poojithas956/MagnumFC/cart/Screenshot 2026-10-18 132400.png

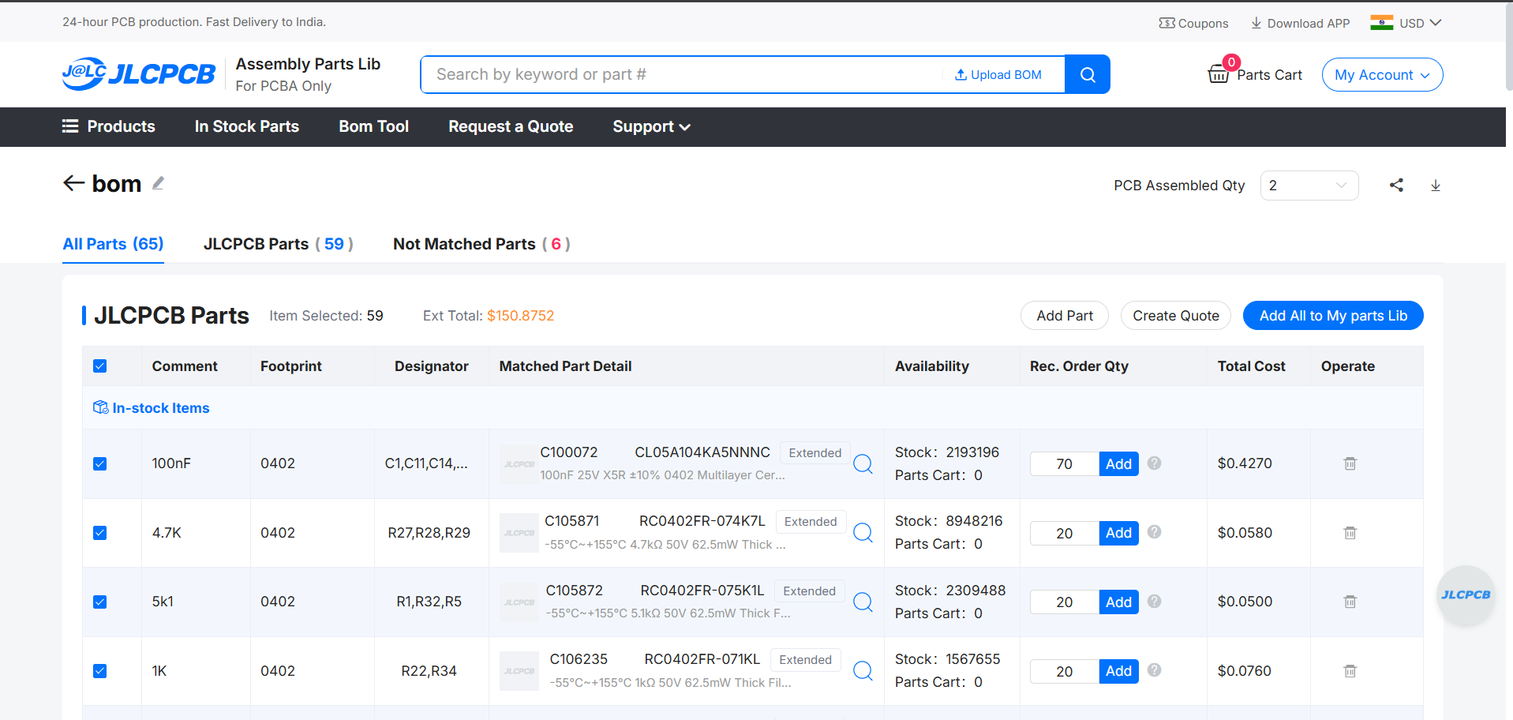
cart/Screenshot 2026-10-18 132400.png
