poojithas956/MagnumFC/cart/Screenshot 2026-10-18 132445.png

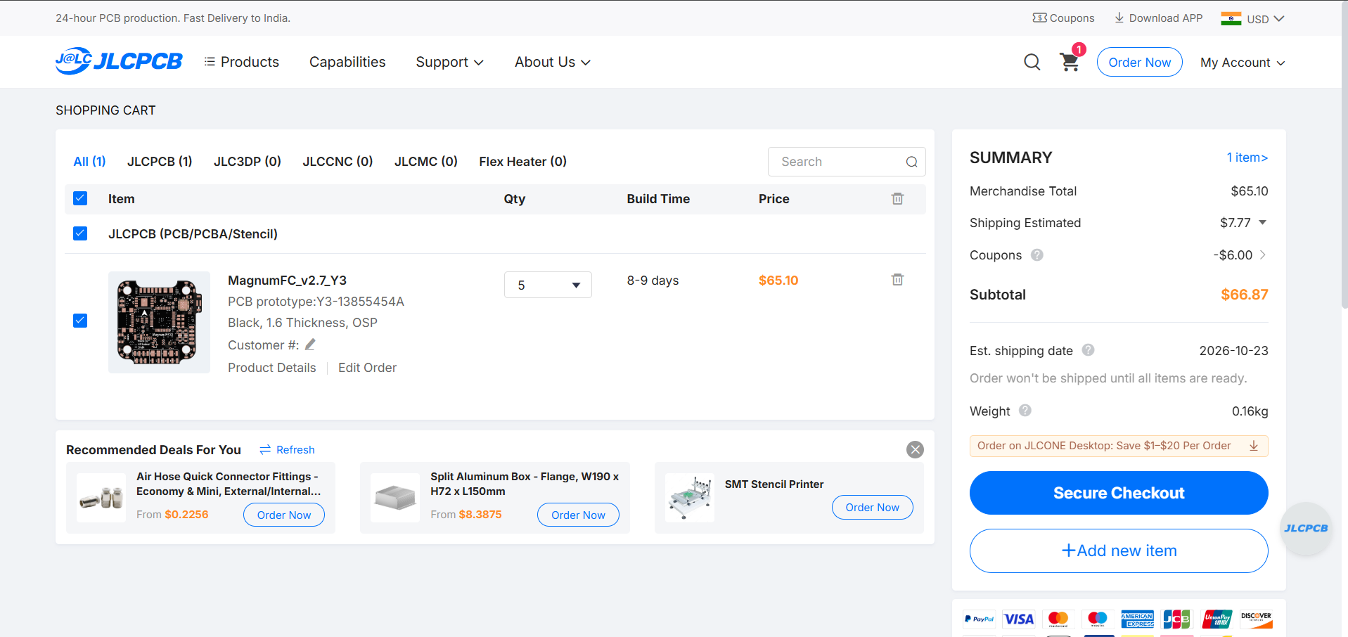
cart/Screenshot 2026-10-18 132445.png
