poojithas956/MagnumFC/PCB/MagnumFC-back.png

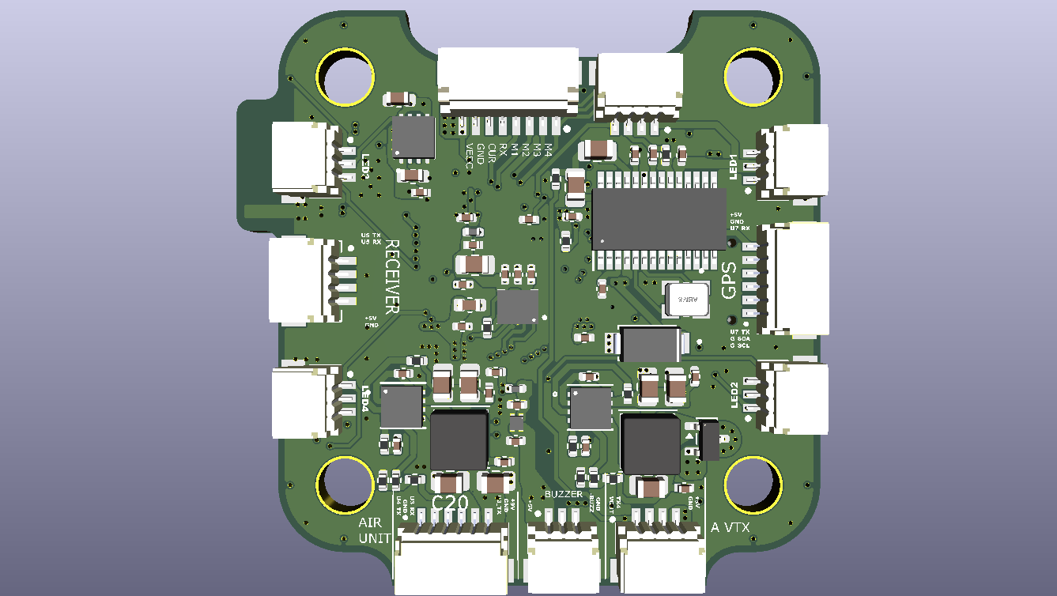
PCB/MagnumFC-back.png
