poojithas956/MagnumFC/PCB/MagnumFC-front.png

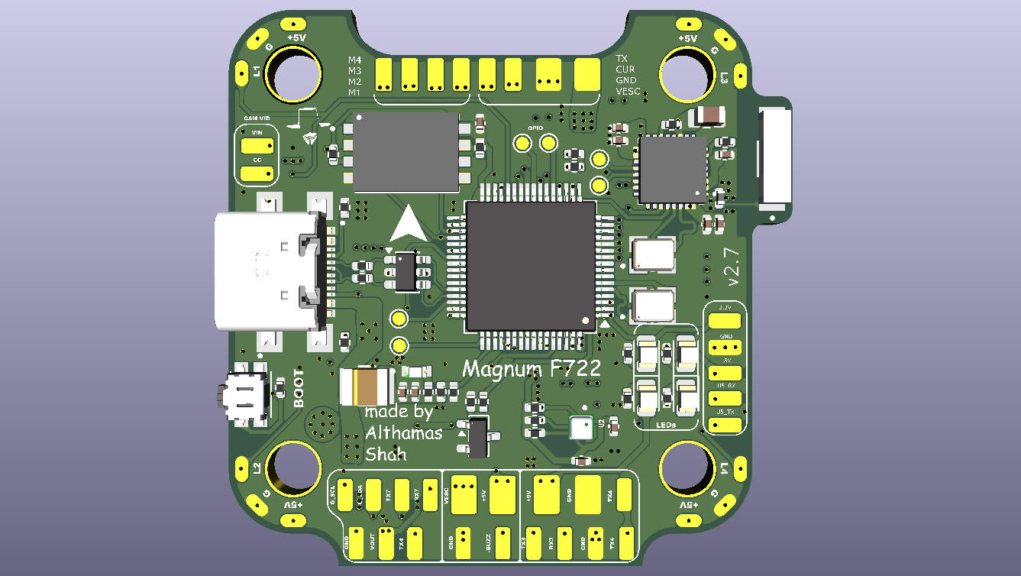
PCB/MagnumFC-front.png
