poojithas956/MagnumFC/Screenshots/3v3 Analog.png

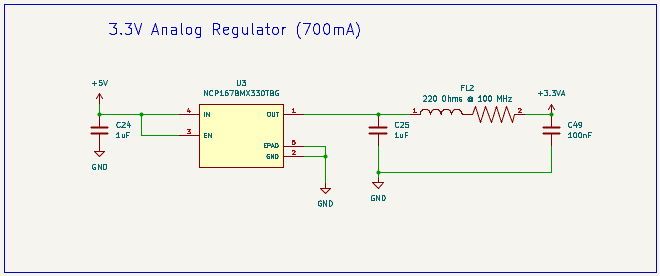
Screenshots/3v3 Analog.png
