poojithas956/MagnumFC/Screenshots/3v3.png

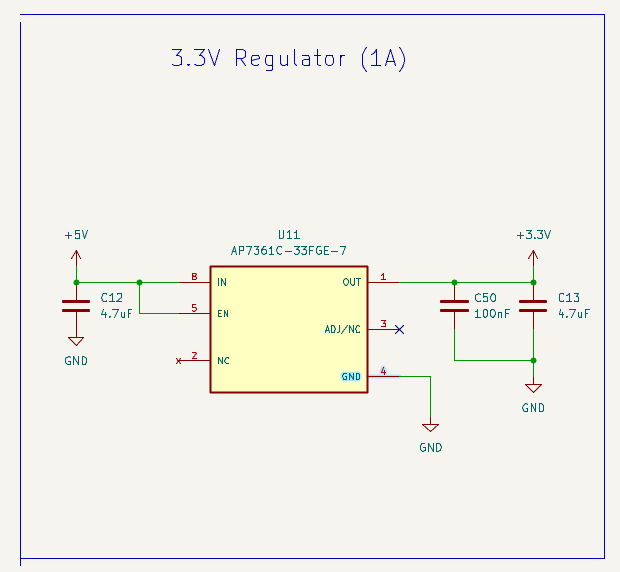
Screenshots/3v3.png
