poojithas956/MagnumFC/Screenshots/back.silkscreen.png

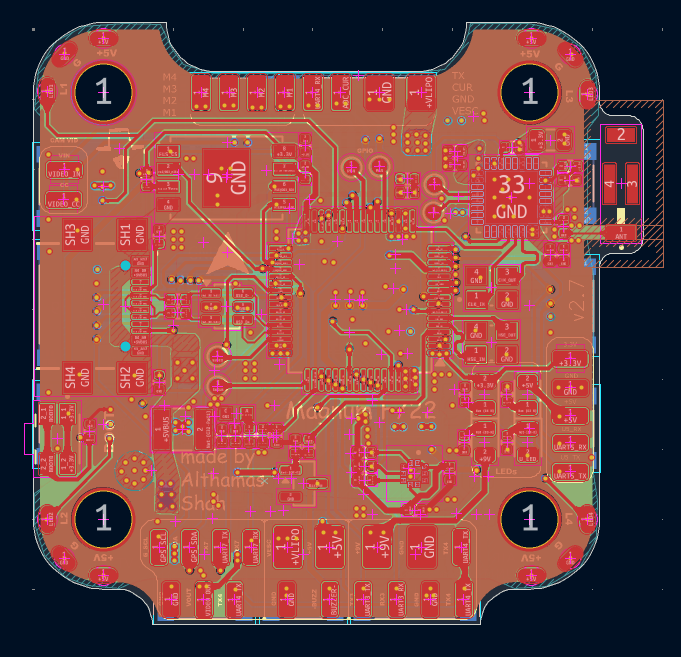
Screenshots/back.silkscreen.png
