poojithas956/MagnumFC/Screenshots/BEC 5v.png

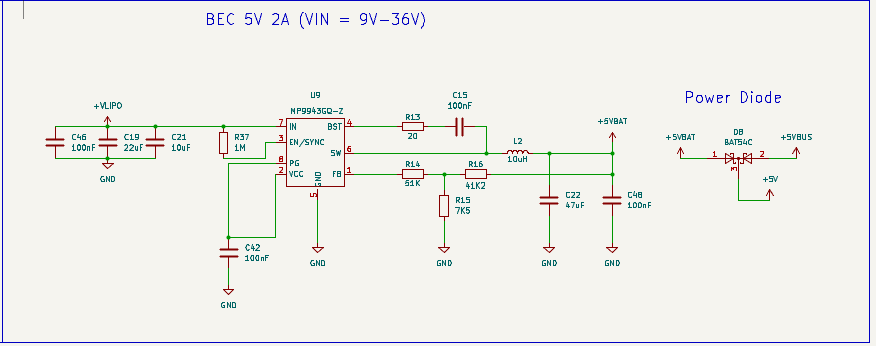
Screenshots/BEC 5v.png
