poojithas956/MagnumFC/Screenshots/BEC 9v.png

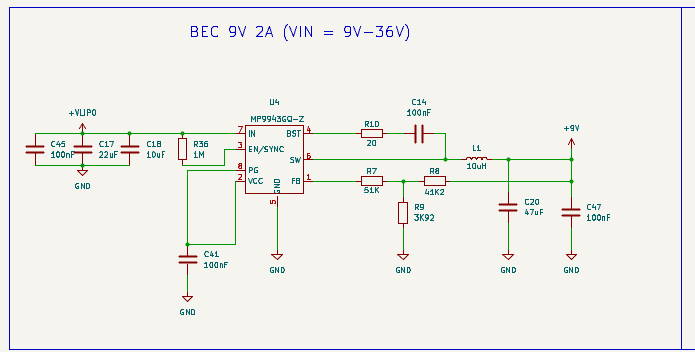
Screenshots/BEC 9v.png
