poojithas956/MagnumFC/Screenshots/Buzzer.png

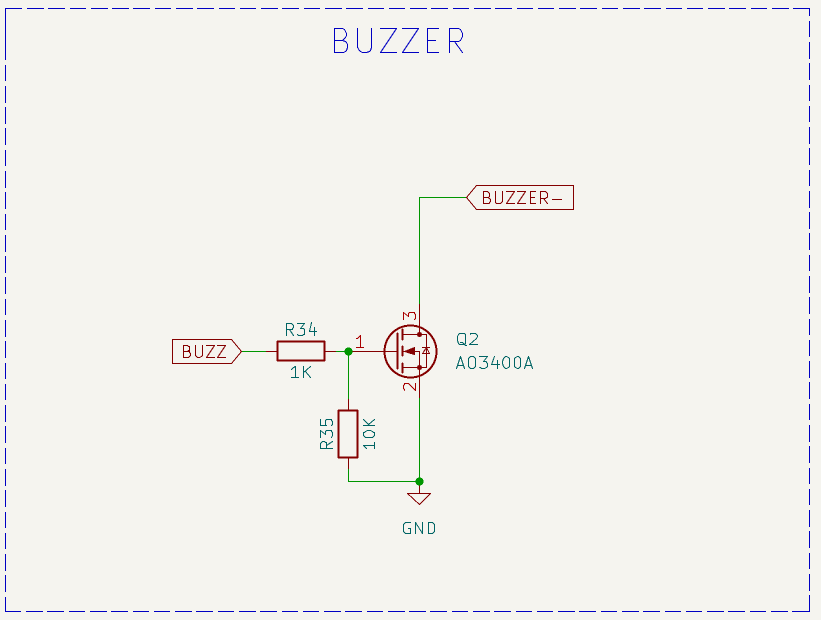
Screenshots/Buzzer.png
