poojithas956/MagnumFC/Screenshots/ESP32-C3.png

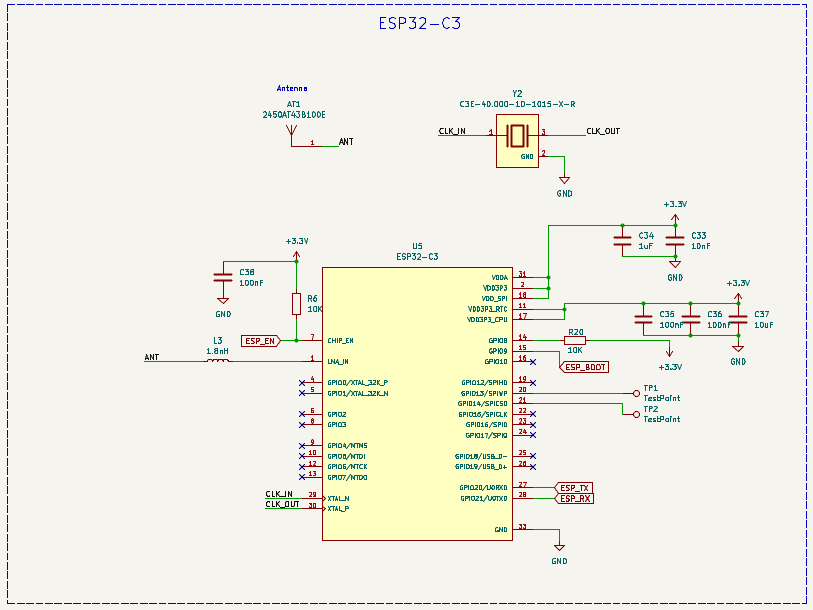
Screenshots/ESP32-C3.png
