poojithas956/MagnumFC/Screenshots/External LEDs.png

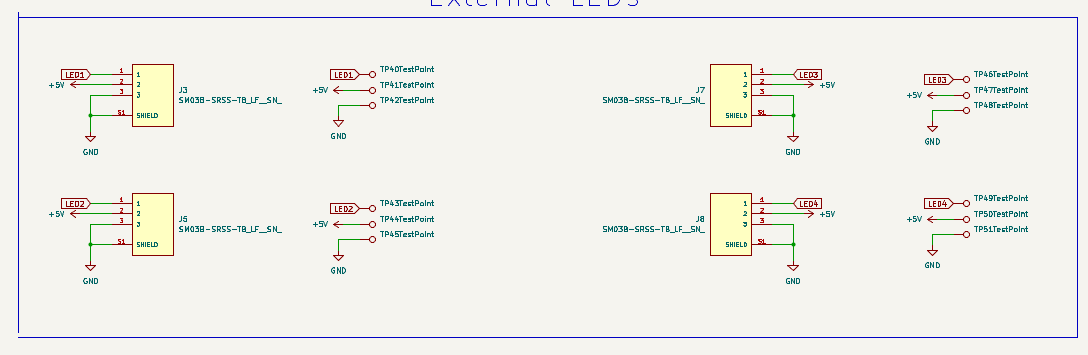
Screenshots/External LEDs.png
