poojithas956/MagnumFC/Screenshots/Flash.png

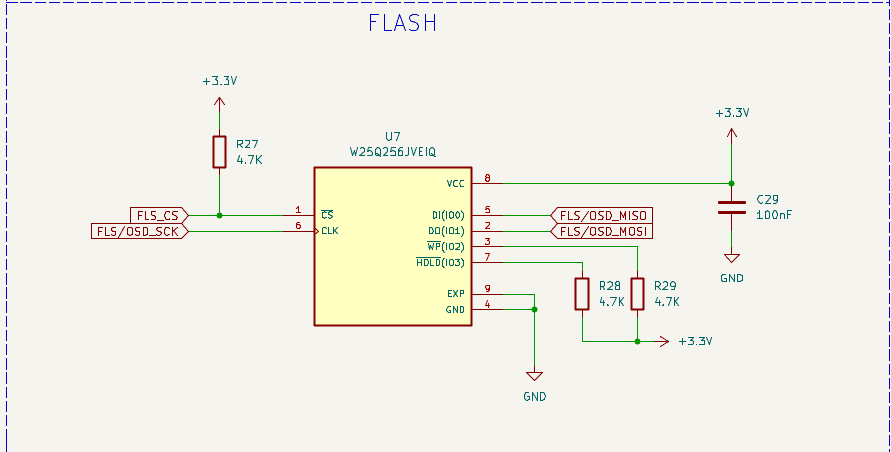
Screenshots/Flash.png
