poojithas956/MagnumFC/Screenshots/front.silkscreen.png

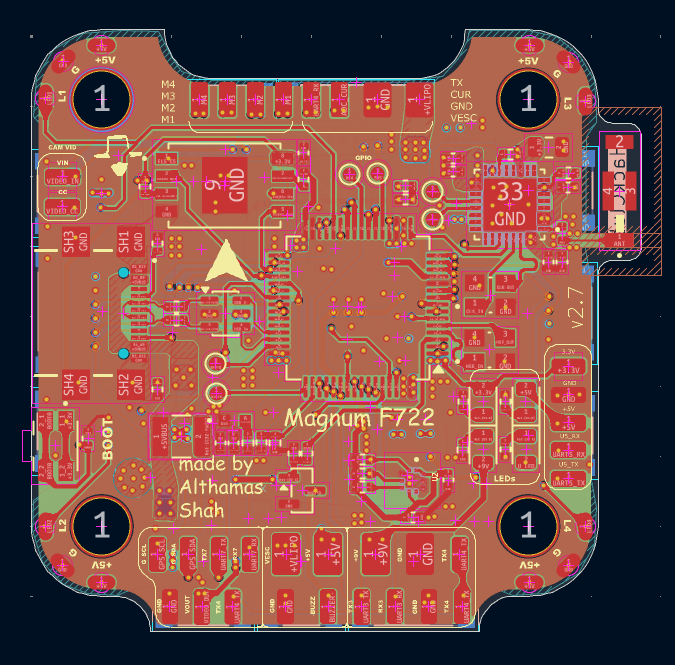
Screenshots/front.silkscreen.png
