poojithas956/MagnumFC/Screenshots/JST conn.png

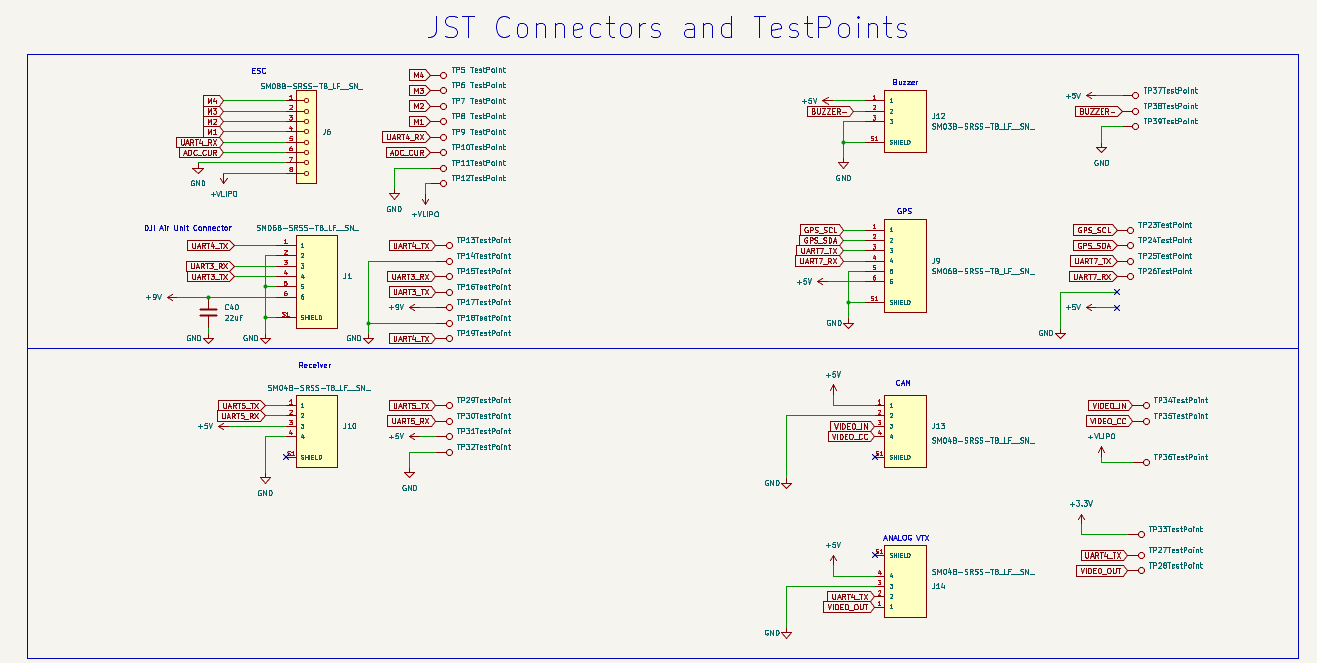
Screenshots/JST conn.png
