poojithas956/MagnumFC/Screenshots/OSD.png

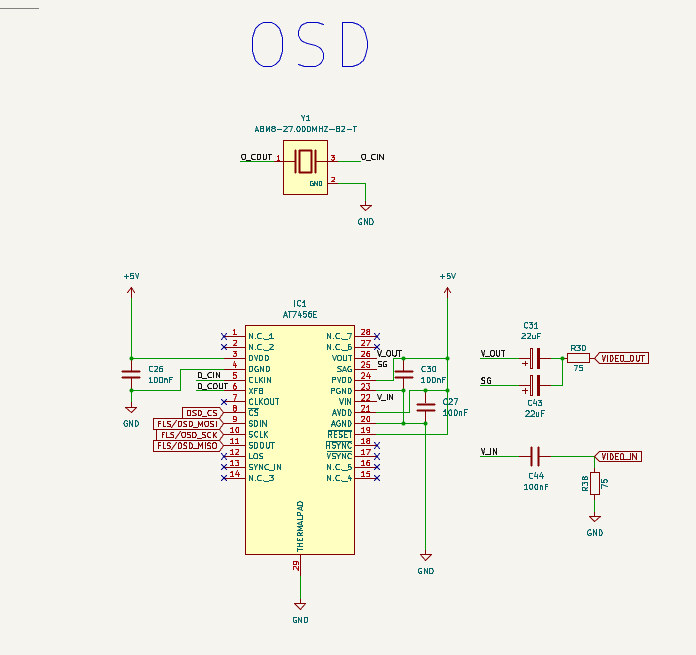
Screenshots/OSD.png
