poojithas956/MagnumFC/Screenshots/PCB.png

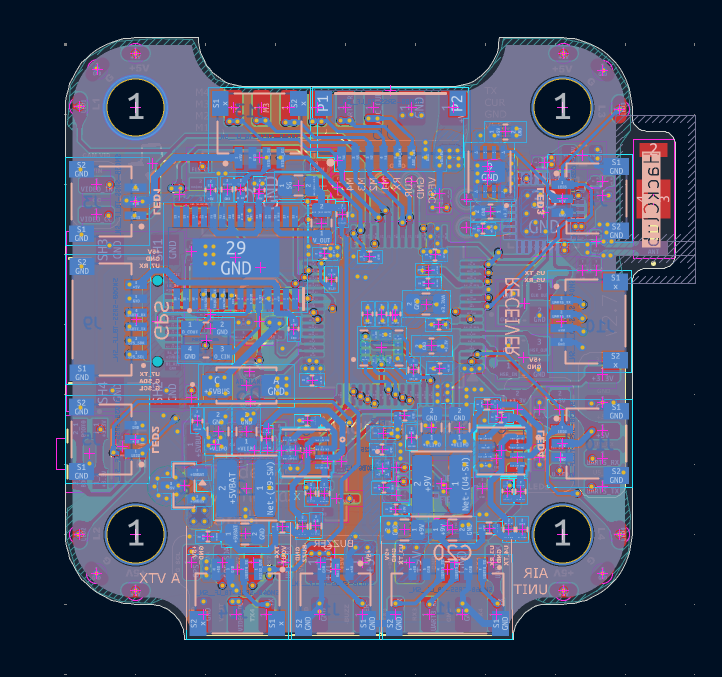
Screenshots/PCB.png
