poojithas956/MagnumFC/Screenshots/Sch2.png

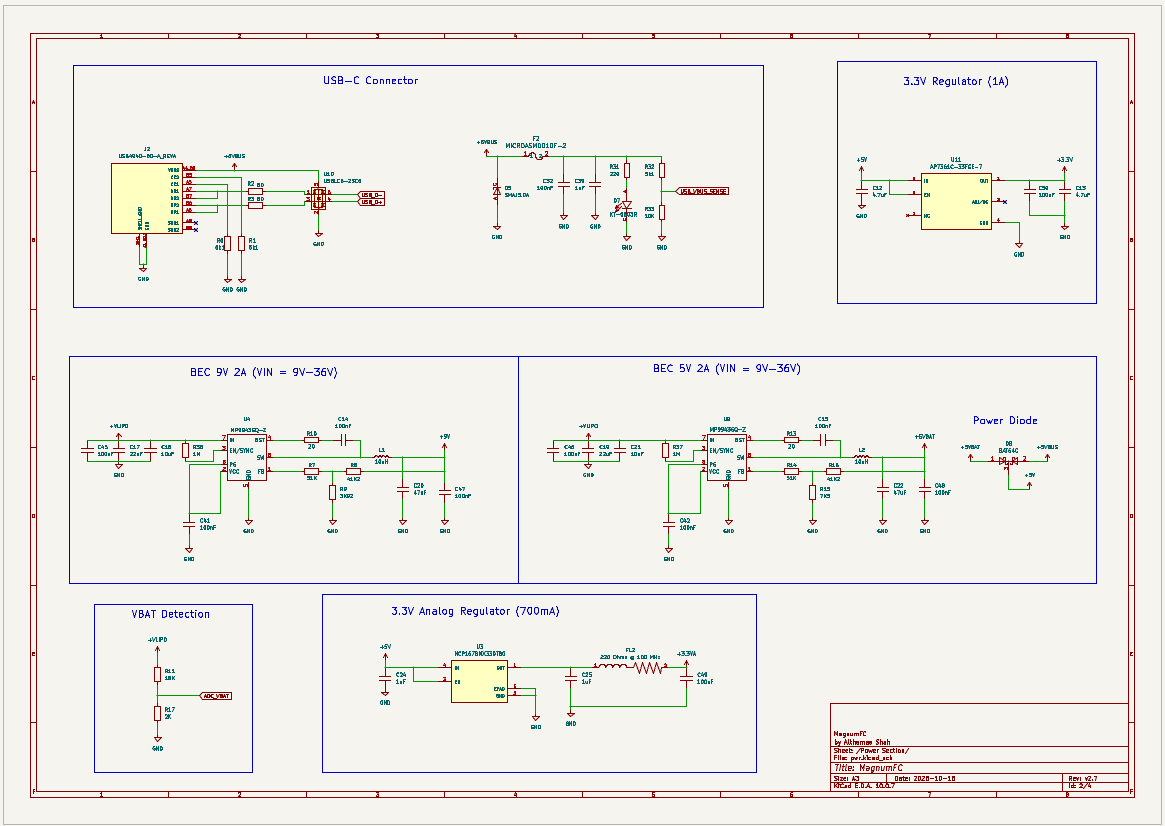
Screenshots/Sch2.png
