poojithas956/MagnumFC/Screenshots/Sch3.png

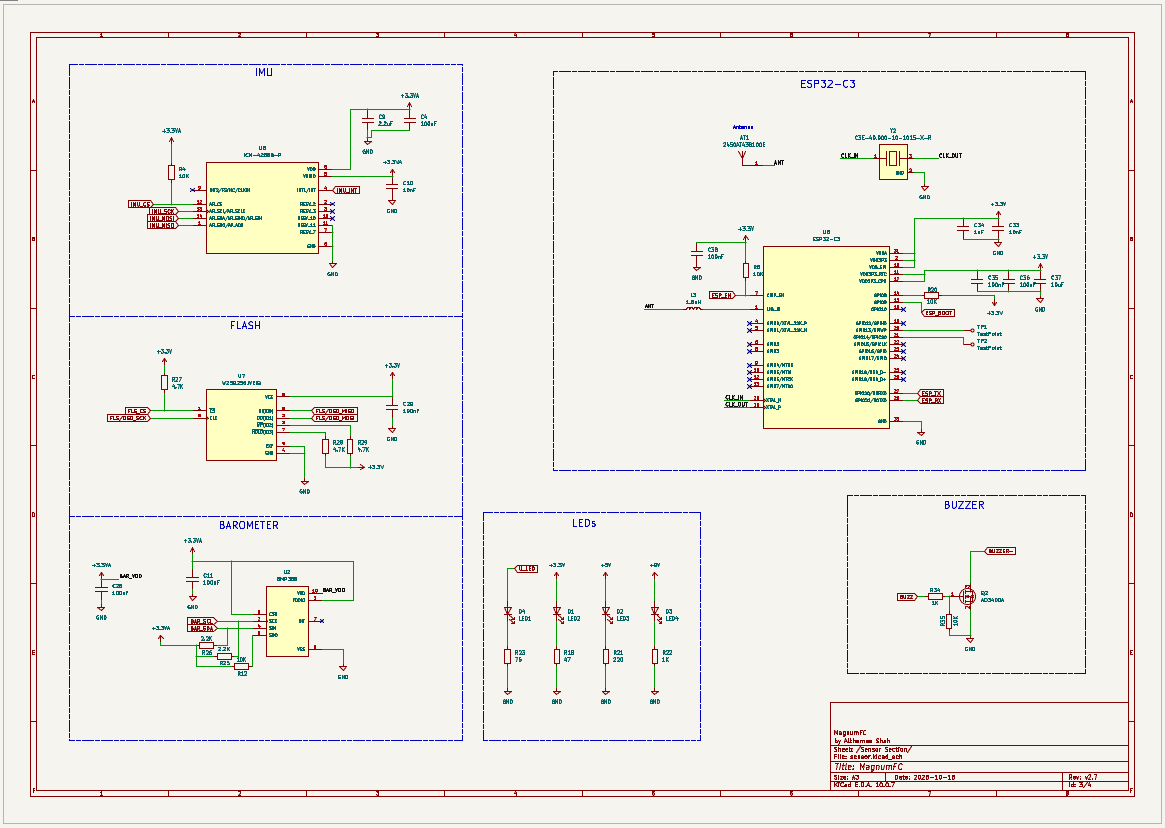
Screenshots/Sch3.png
