poojithas956/MagnumFC/Screenshots/Sch4.png

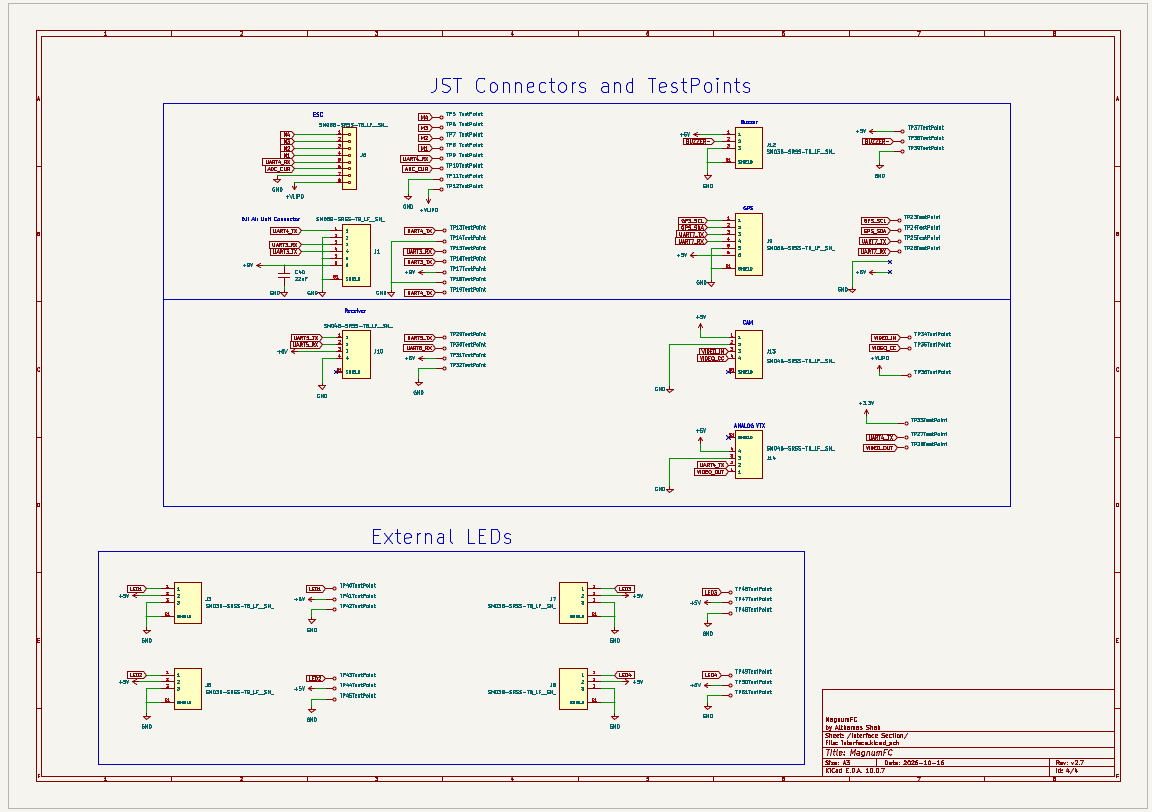
Screenshots/Sch4.png
