poojithas956/MagnumFC/Screenshots/Status LEDs.png

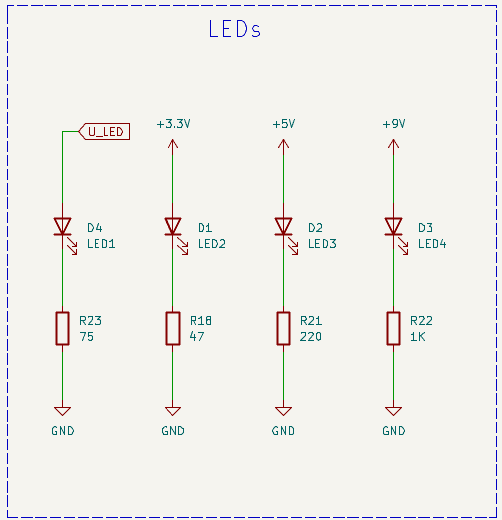
Screenshots/Status LEDs.png
