poojithas956/MagnumFC/Screenshots/VBAT.png

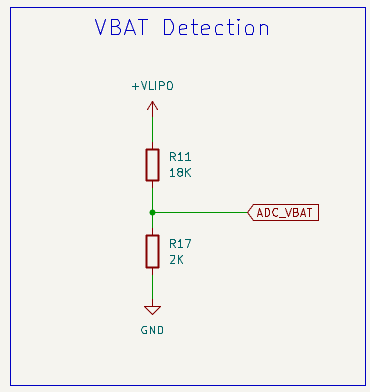
Screenshots/VBAT.png
