poojithas956/MagnumFC/production/bom.csv

Designator | Footprint | Quantity | Value | LCSC Part #
_3, _2, |  | 3
AT1 | ANTENNA_2450AT43B100E | 1 | 2450AT43B100E | C2917721
C1, C11, C14, C15, C16, C2, C23, C26, C27, C28, C29, C3, C30, C32, C35, C36, C38, C4, C41, C42, C44, C45, C46, C47, C48, C49, C50, C6 | 0402 | 28 | 100nF | C100072
C10, C33 | 0402 | 2 | 10nF | C15195
C12, C13, C5 | 0603 | 3 | 4.7uF | C19666
C17, C19, C31, C40, C43 | 0805 | 5 | 22uF | C22367832
C18, C21, C37 | 0805 | 3 | 10uF | C2932476
C20, C22 | 0805 | 2 | 47uF | C5596752
C24, C25, C34, C39 | 0402 | 4 | 1uF | C29266
C7 | 0805 | 1 | 1uF | C24123
C8, C9 | 0402 | 2 | 2.2uF | C107369
D1 | 0805 | 1 | LED2 | C2293
D2 | 0805 | 1 | LED3 | C2296
D3 | 0805 | 1 | LED4 | C2297
D4 | 0805 | 1 | LED1 | C2295
D5 | DIOM4325X250N | 1 | SMAJ5.0A | C83329
D7 | LED_KT-0603R | 1 | KT-0603R | C2286
D8 | SOT-23 | 1 | BAT54C | C14308
F2 | FUSE_MICROASMD010F_LTF | 1 | MICROASMD010F-2 | C2649903
FL1 | 0402 | 1 | 120 Ohms @ 100 MHz | C107331
FL2 | 0402 | 1 | 220 Ohms @ 100 MHz | C85818
IC1 | SOP65P640X120-29N | 1 | AT7456E | C82351
J1, J9 | JST_SM06B-SRSS-TB_LF__SN_ | 2 | SM06B-SRSS-TB_LF__SN_ | C2845365
J10, J13, J14 | JST_SM04B-SRSS-TB_LF__SN_ | 3 | SM04B-SRSS-TB_LF__SN_ | C2845363
J12, J3, J5, J7, J8 | JST_SM03B-SRSS-TB_LF__SN_ | 5 | SM03B-SRSS-TB_LF__SN_ | C2845362
J2 | GCT_USB4940-00-A_REVA | 1 | USB4940-00-A_REVA | C54829818
J6 | JST_SM08B-SRSS-TB_LF__SN_ | 1 | SM08B-SRSS-TB_LF__SN_ | C160407
L1, L2 | L_Changjiang_FTC404020S | 2 | 10uH | C53198553
L3 | 0402 | 1 | 1.8nH | C77107
Q2 | SOT-23 | 1 | AO3400A | C20917
R1, R32, R5 | 0402 | 3 | 5k1 | C105872
R10, R13 | 0402 | 2 | 20 | C138031
R11 | 0402 | 1 | 18K | C25762
R12, R20, R24, R33, R35, R4, R6 | 0402 | 7 | 10K | C60489
R14, R7 | 0402 | 2 | 51K | C107229
R15 | 0402 | 1 | 7K5 | C25918
R16, R8 | 0402 | 2 | 41K2 | C844310
R17 | 0402 | 1 | 2K | C60488
R18 | 0402 | 1 | 47 | C137973
R2, R3 | 0402 | 2 | 80 | C185392
R21, R31 | 0402 | 2 | 220 | C112291
R22, R34 | 0402 | 2 | 1K | C106235
R23, R30, R38 | 0402 | 3 | 75 | C137841
R25, R26 | 0402 | 2 | 2.2K | C163447
R27, R28, R29 | 0402 | 3 | 4.7K | C105871
R36, R37 | 0402 | 2 | 1M | C93949
R9 | 0402 | 1 | 3K92 | C131467
S2 | SW_EVQ-P7A01P | 1 | EVQ-P7A01P | C79167
TP1, TP10, TP2, TP20, TP21, TP3, TP4, TP40, TP41, TP42, TP43, TP44, TP45, TP46, TP47, TP48, TP49, TP5, TP50, TP51, TP6, TP7, TP8, TP9 | TestPoint_Pad_D1.0mm | 24 | TestPoint | -
TP11, TP12 | TestPoint_Pad_D2.0mm | 2 | TestPoint | -
TP13, TP14, TP15, TP16, TP18, TP19, TP23, TP24, TP25, TP26, TP27, TP28, TP29, TP30, TP32, TP33, TP34, TP35, TP36_2, TP38, TP39 | TestPoint_Pad_1.0x1.0mm | 21 | TestPoint | -
TP17, TP31, TP37 | TestPoint_Pad_2.0x2.0mm | 3 | TestPoint | -
TP36 | TestPoint_Pad_1.0x1.0mm | 1 | TestPoint
U1 | LQFP-64_10x10mm_P0.5mm | 1 | STM32F722RETx | C118207
U10 | SOT-23-6 | 1 | USBLC6-2SC6 | C7519
U11 | SON65P300X300X63-9N | 1 | AP7361C-33FGE-7 | C151007
U2 | XDCR_BMP388 | 1 | BMP388 | C779278
U3 | VREG_NCP167BMX330TBG | 1 | NCP167BMX330TBG | C892227
U4, U9 | QFN-8_MP9943_MNP | 2 | MP9943GQ-Z | Mouser No: 946-MP9943GQ-Z
U5 | QFN50P500X500X90-33N | 1 | ESP32-C3 | C2838500
U6 | PQFN50P300X250X97-14N | 1 | ICM-42688-P | C1850418, Mouser No: 410-ICM-42688-P
U7 | IC_W25N04KVZEIR | 1 | W25Q256JVEIQ | C97522
Y1 | XTAL_ABM8-27.000MHZ-B2-T | 1 | ABM8-27.000MHZ-B2-T | C1985251
Y2 | XTAL_C3E-40.000-10-1015-X-R | 1 | C3E-40.000-10-1015-X-R | C5444549
Y3 | XTAL_C3E-8.000-18-3030-X-R | 1 | C3E-8.000-18-3030-X-R | C2682775
