poojithas956/MagnumFC/Screenshots/components-back.png

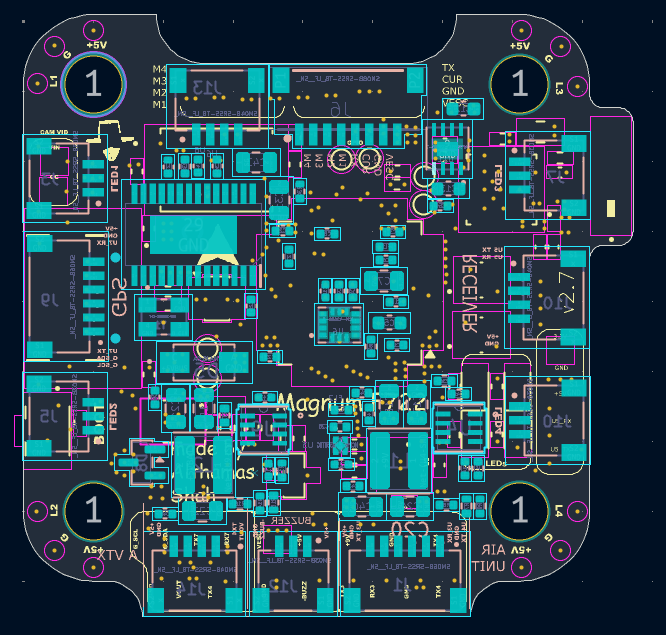
Screenshots/components-back.png
