poojithas956/MagnumFC/Screenshots/components-front.png

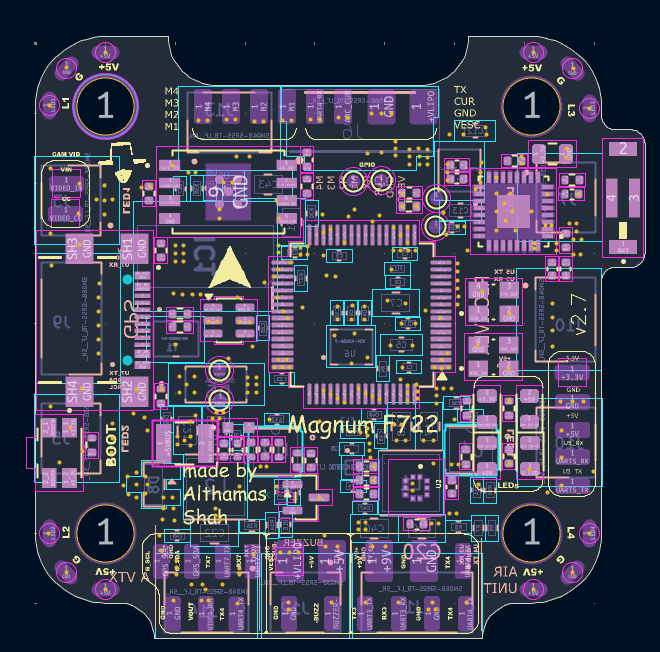
Screenshots/components-front.png
