poojithas956/MagnumFC/PCB/MagnumFC.kicad_pcb

## KiCad design PCB/MagnumFC.kicad_pcb (2026-10-20)

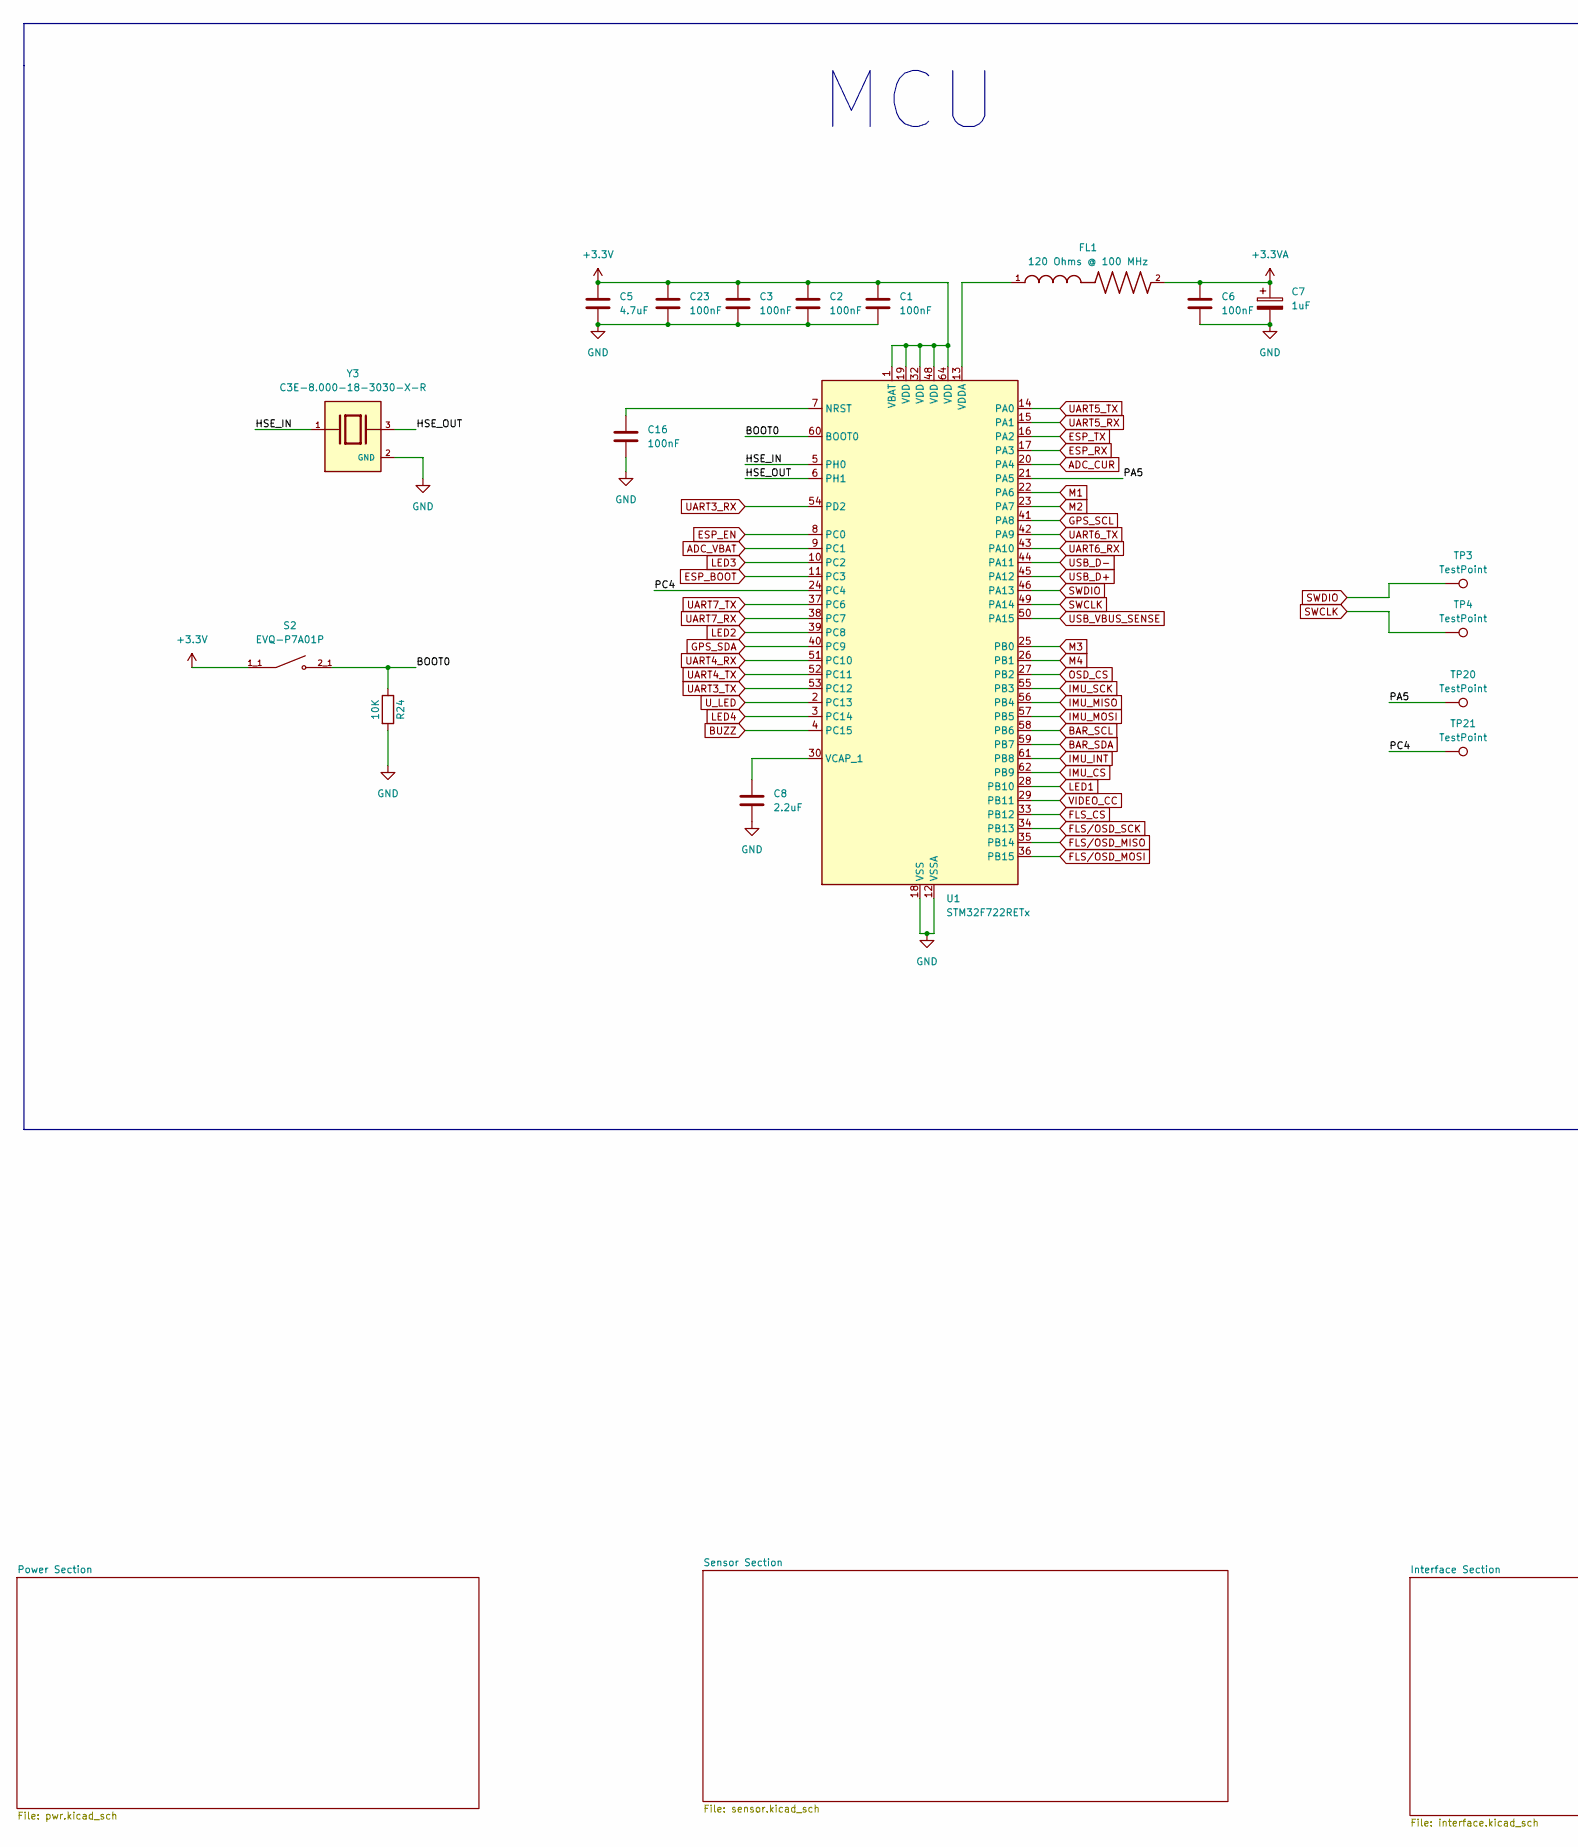
[picture p34: schematic MagnumFC.kicad_sch, part in row 1, column 1]

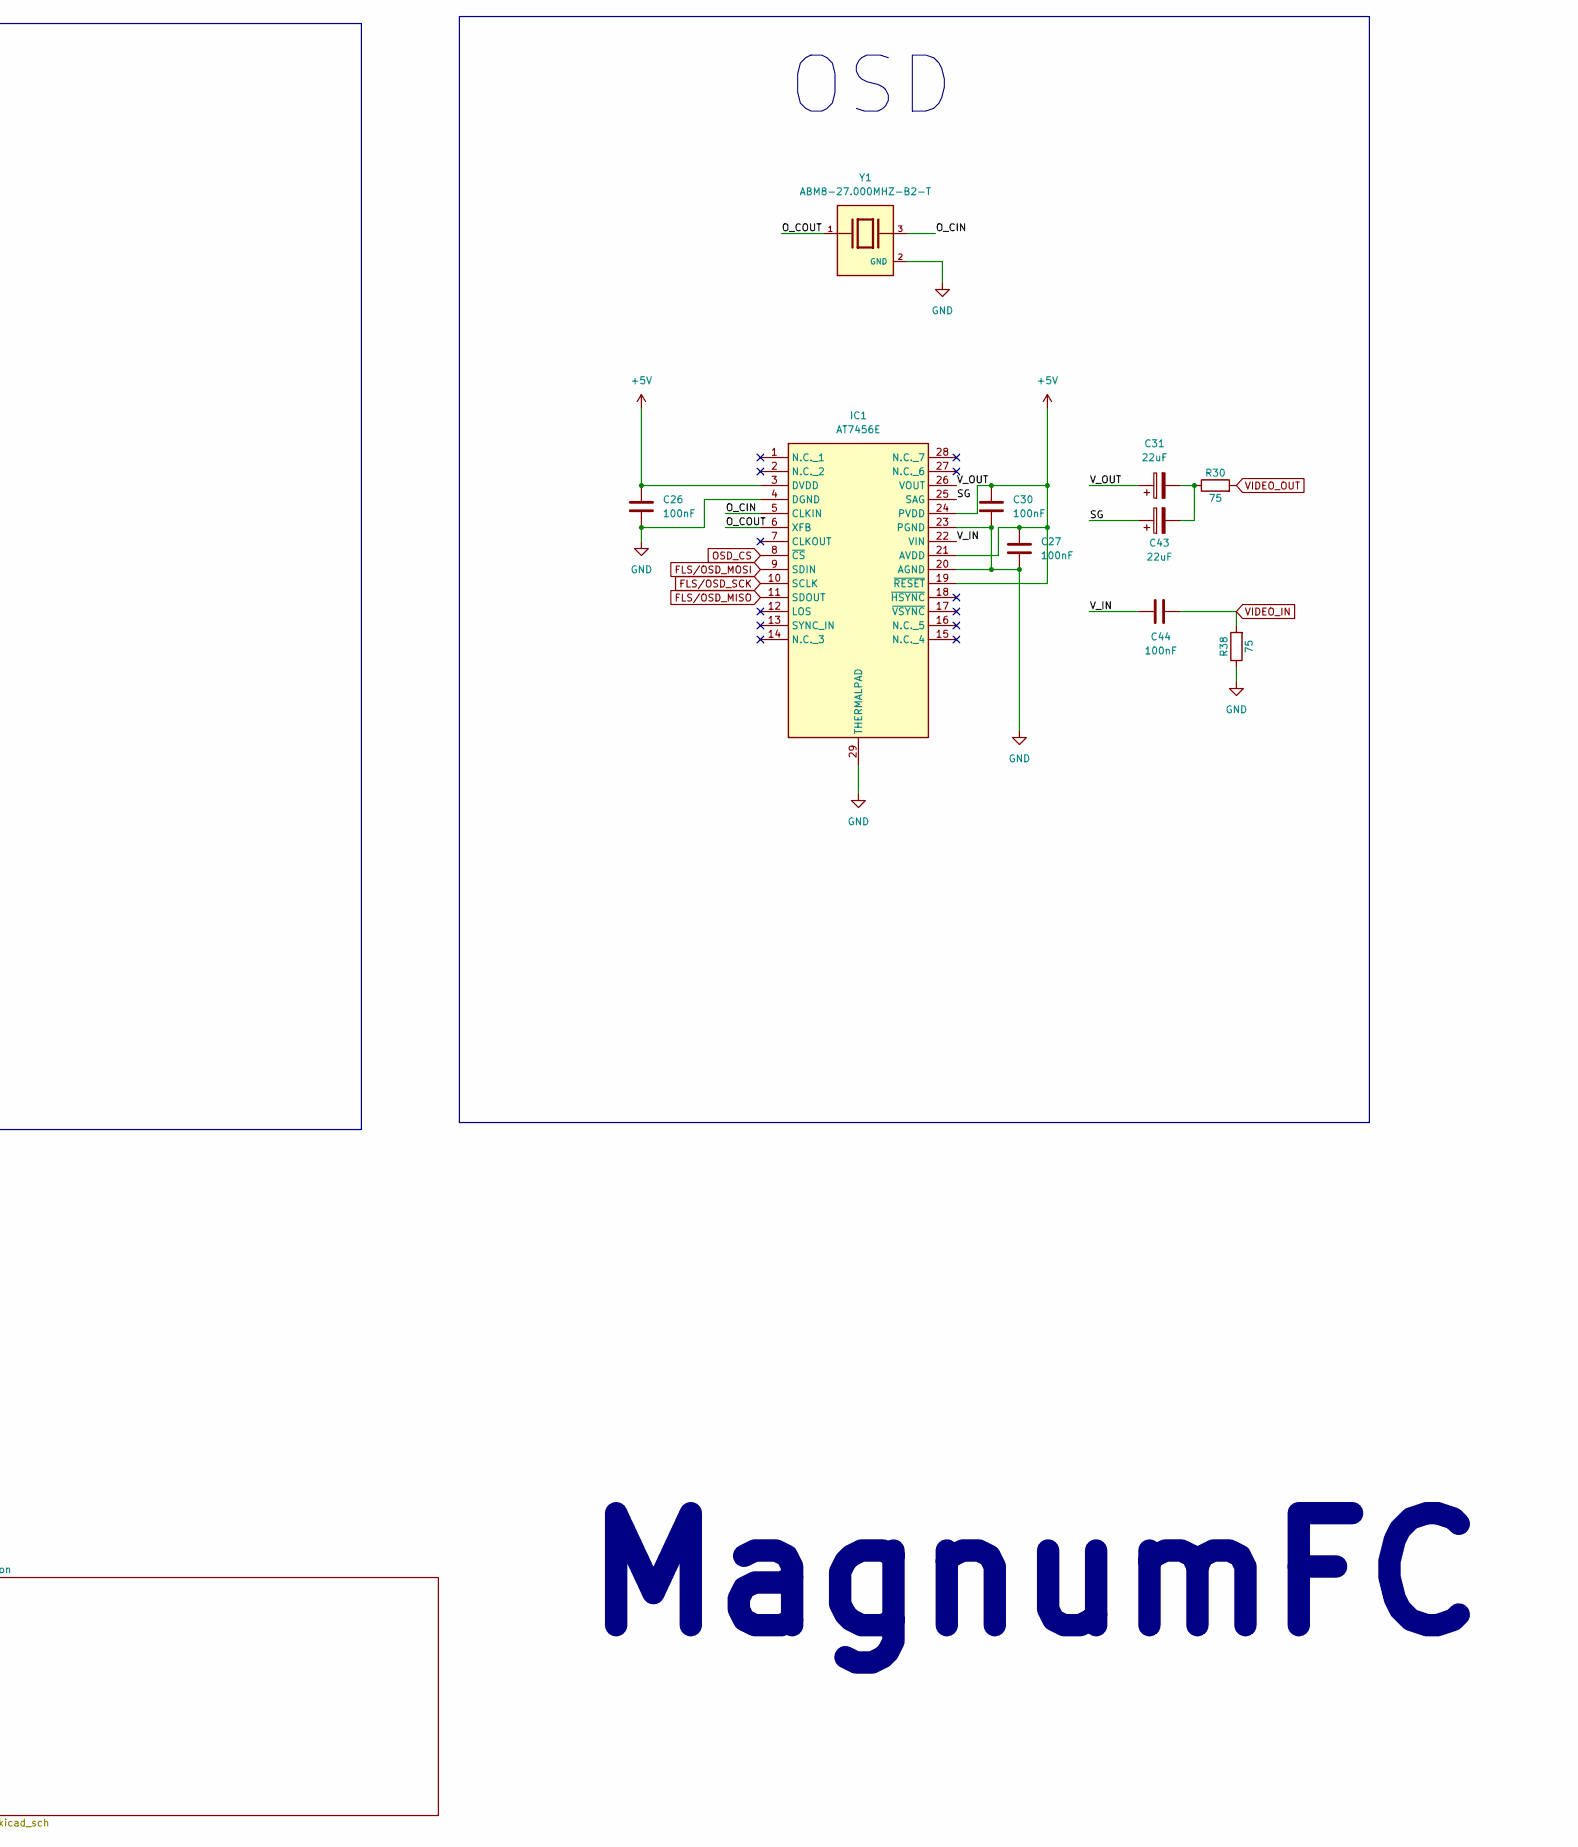
[picture p35: schematic MagnumFC.kicad_sch, part in row 1, column 2]

Parts:
C1, C2, C3, C6, C16, C23, C26, C27, C30, C44: 100nF; C_0402_1005Metric; MANUFACTURER PART NUMBER CL05A104KA5NNNC; LCSC C100072
C5: 4.7uF; C_0603_1608Metric; MANUFACTURER PART NUMBER CL10A475KO8NNNC; LCSC C19666
C7: 1uF; C_0805_2012Metric; MANUFACTURER PART NUMBER CL21B105KOFNNNE; LCSC C24123
C8: 2.2uF; C_0402_1005Metric; MANUFACTURER PART NUMBER CL05A225KP5NSNC; LCSC C107369
C31, C43: 22uF; C_0805_2012Metric; MANUFACTURER PART NUMBER HGC0805R5226M350NSLJ; LCSC C22367832
FL1: 120 Ohms @ 100 MHz; L_0402_1005Metric; MANUFACTURER PART NUMBER MPZ1005S121CT000; LCSC C107331
IC1: AT7456E; SOP65P640X120-29N; Manufacturer_Part_Number AT7456E; LCSC C82351
R24: 10K; R_0402_1005Metric; MANUFACTURER PART NUMBER RC0402JR-0710KL; LCSC C60489
R30, R38: 75; R_0402_1005Metric; MANUFACTURER PART NUMBER RC0402JR-0775RL; LCSC C137841
S2: EVQ-P7A01P; SW_EVQ-P7A01P; PARTREV 2022.4; LCSC C79167
TP3, TP4, TP20, TP21: TestPoint; TestPoint_Pad_D1.0mm
U1: STM32F722RETx; LQFP-64_10x10mm_P0.5mm; MANUFACTURER PART NUMBER STM32F722RET6; LCSC C118207
Y1: ABM8-27.000MHZ-B2-T; XTAL_ABM8-27.000MHZ-B2-T; PARTREV 44041; LCSC C1985251
Y3: C3E-8.000-18-3030-X-R; XTAL_C3E-8.000-18-3030-X-R; PARTREV August 01, 2022; LCSC C2682775

Connections:
+3.3V: C1.1, C2.1, C3.1, C5.1, C23.1, S2.1_1, S2.1_2, U1.1 (VBAT), U1.19 (VDD), U1.32 (VDD), U1.48 (VDD), U1.64 (VDD); also elsewhere on the board
+3.3VA: C6.1, C7.1, FL1.2; also elsewhere on the board
+5V: C26.1, C27.1, C30.1, IC1.3 (DVDD), IC1.19 (~RESET), IC1.21 (AVDD), IC1.24 (PVDD); also elsewhere on the board
/BOOT0: R24.1, S2.2_1, S2.2_2, U1.60 (BOOT0)
/HSE_IN: U1.5 (PH0), Y3.1
/HSE_OUT: U1.6 (PH1), Y3.3
/O_CIN: IC1.5 (CLKIN), Y1.3
/O_COUT: IC1.6 (XFB), Y1.1
/PA5: TP20.1 (1_1), U1.21 (PA5)
/PC4: TP21.1 (1_1), U1.24 (PC4)
/SG: C43.1, IC1.25 (SAG)
/V_IN: C44.1, IC1.22 (VIN)
/V_OUT: C31.1, IC1.26 (VOUT)
ADC_CUR: U1.20 (PA4); also elsewhere on the board
ADC_VBAT: U1.9 (PC1); also elsewhere on the board
BAR_SCL: U1.58 (PB6); also elsewhere on the board
BAR_SDA: U1.59 (PB7); also elsewhere on the board
BUZZ: U1.4 (PC15); also elsewhere on the board
ESP_BOOT: U1.11 (PC3); also elsewhere on the board
ESP_EN: U1.8 (PC0); also elsewhere on the board
ESP_RX: U1.17 (PA3); also elsewhere on the board
ESP_TX: U1.16 (PA2); also elsewhere on the board
FLS_CS: U1.33 (PB12); also elsewhere on the board
FLS/OSD_MISO: IC1.11 (SDOUT), U1.35 (PB14); also elsewhere on the board
FLS/OSD_MOSI: IC1.9 (SDIN), U1.36 (PB15); also elsewhere on the board
FLS/OSD_SCK: IC1.10 (SCLK), U1.34 (PB13); also elsewhere on the board
GND: C1.2, C2.2, C3.2, C5.2, C6.2, C7.2, C8.2, C16.2, C23.2, C26.2, C27.2, C30.2, IC1.4 (DGND), IC1.20 (AGND), IC1.23 (PGND), IC1.29 (THERMALPAD), R24.2, R38.1, U1.12 (VSSA), U1.18 (VSS), U1.31 (VSS), U1.47 (VSS), U1.63 (VSS), Y1.2 (GND), Y1.4 (GND), Y3.2 (GND), Y3.4 (GND); also elsewhere on the board
GPS_SCL: U1.41 (PA8); also elsewhere on the board
GPS_SDA: U1.40 (PC9); also elsewhere on the board
IMU_CS: U1.62 (PB9); also elsewhere on the board
IMU_INT: U1.61 (PB8); also elsewhere on the board
IMU_MISO: U1.56 (PB4); also elsewhere on the board
IMU_MOSI: U1.57 (PB5); also elsewhere on the board
IMU_SCK: U1.55 (PB3); also elsewhere on the board
LED1: U1.28 (PB10); also elsewhere on the board
LED2: U1.39 (PC8); also elsewhere on the board
LED3: U1.10 (PC2); also elsewhere on the board
LED4: U1.3 (PC14); also elsewhere on the board
M1: U1.22 (PA6); also elsewhere on the board
M2: U1.23 (PA7); also elsewhere on the board
M3: U1.25 (PB0); also elsewhere on the board
M4: U1.26 (PB1); also elsewhere on the board
unnamed: C31.2, C43.2, R30.1
unnamed: C16.1, U1.7 (NRST)
unnamed: C8.1, U1.30 (VCAP_1)
unnamed: FL1.1, U1.13 (VDDA)
OSD_CS: IC1.8 (~CS), U1.27 (PB2)
SWCLK: TP4.1 (1_1), U1.49 (PA14)
SWDIO: TP3.1 (1_1), U1.46 (PA13)
UART3_RX: U1.54 (PD2); also elsewhere on the board
UART3_TX: U1.53 (PC12); also elsewhere on the board
UART4_RX: U1.51 (PC10); also elsewhere on the board
UART4_TX: U1.52 (PC11); also elsewhere on the board
UART5_RX: U1.15 (PA1); also elsewhere on the board
UART5_TX: U1.14 (PA0); also elsewhere on the board
UART6_RX: U1.43 (PA10)
UART6_TX: U1.42 (PA9)
UART7_RX: U1.38 (PC7); also elsewhere on the board
UART7_TX: U1.37 (PC6); also elsewhere on the board
USB_D+: U1.45 (PA12); also elsewhere on the board
USB_D-: U1.44 (PA11); also elsewhere on the board
USB_VBUS_SENSE: U1.50 (PA15); also elsewhere on the board
U_LED: U1.2 (PC13); also elsewhere on the board
VIDEO_CC: U1.29 (PB11); also elsewhere on the board
VIDEO_IN: C44.2, R38.2; also elsewhere on the board
VIDEO_OUT: R30.2; also elsewhere on the board

Notes on the sheet:
MagnumFC
MCU
OSD

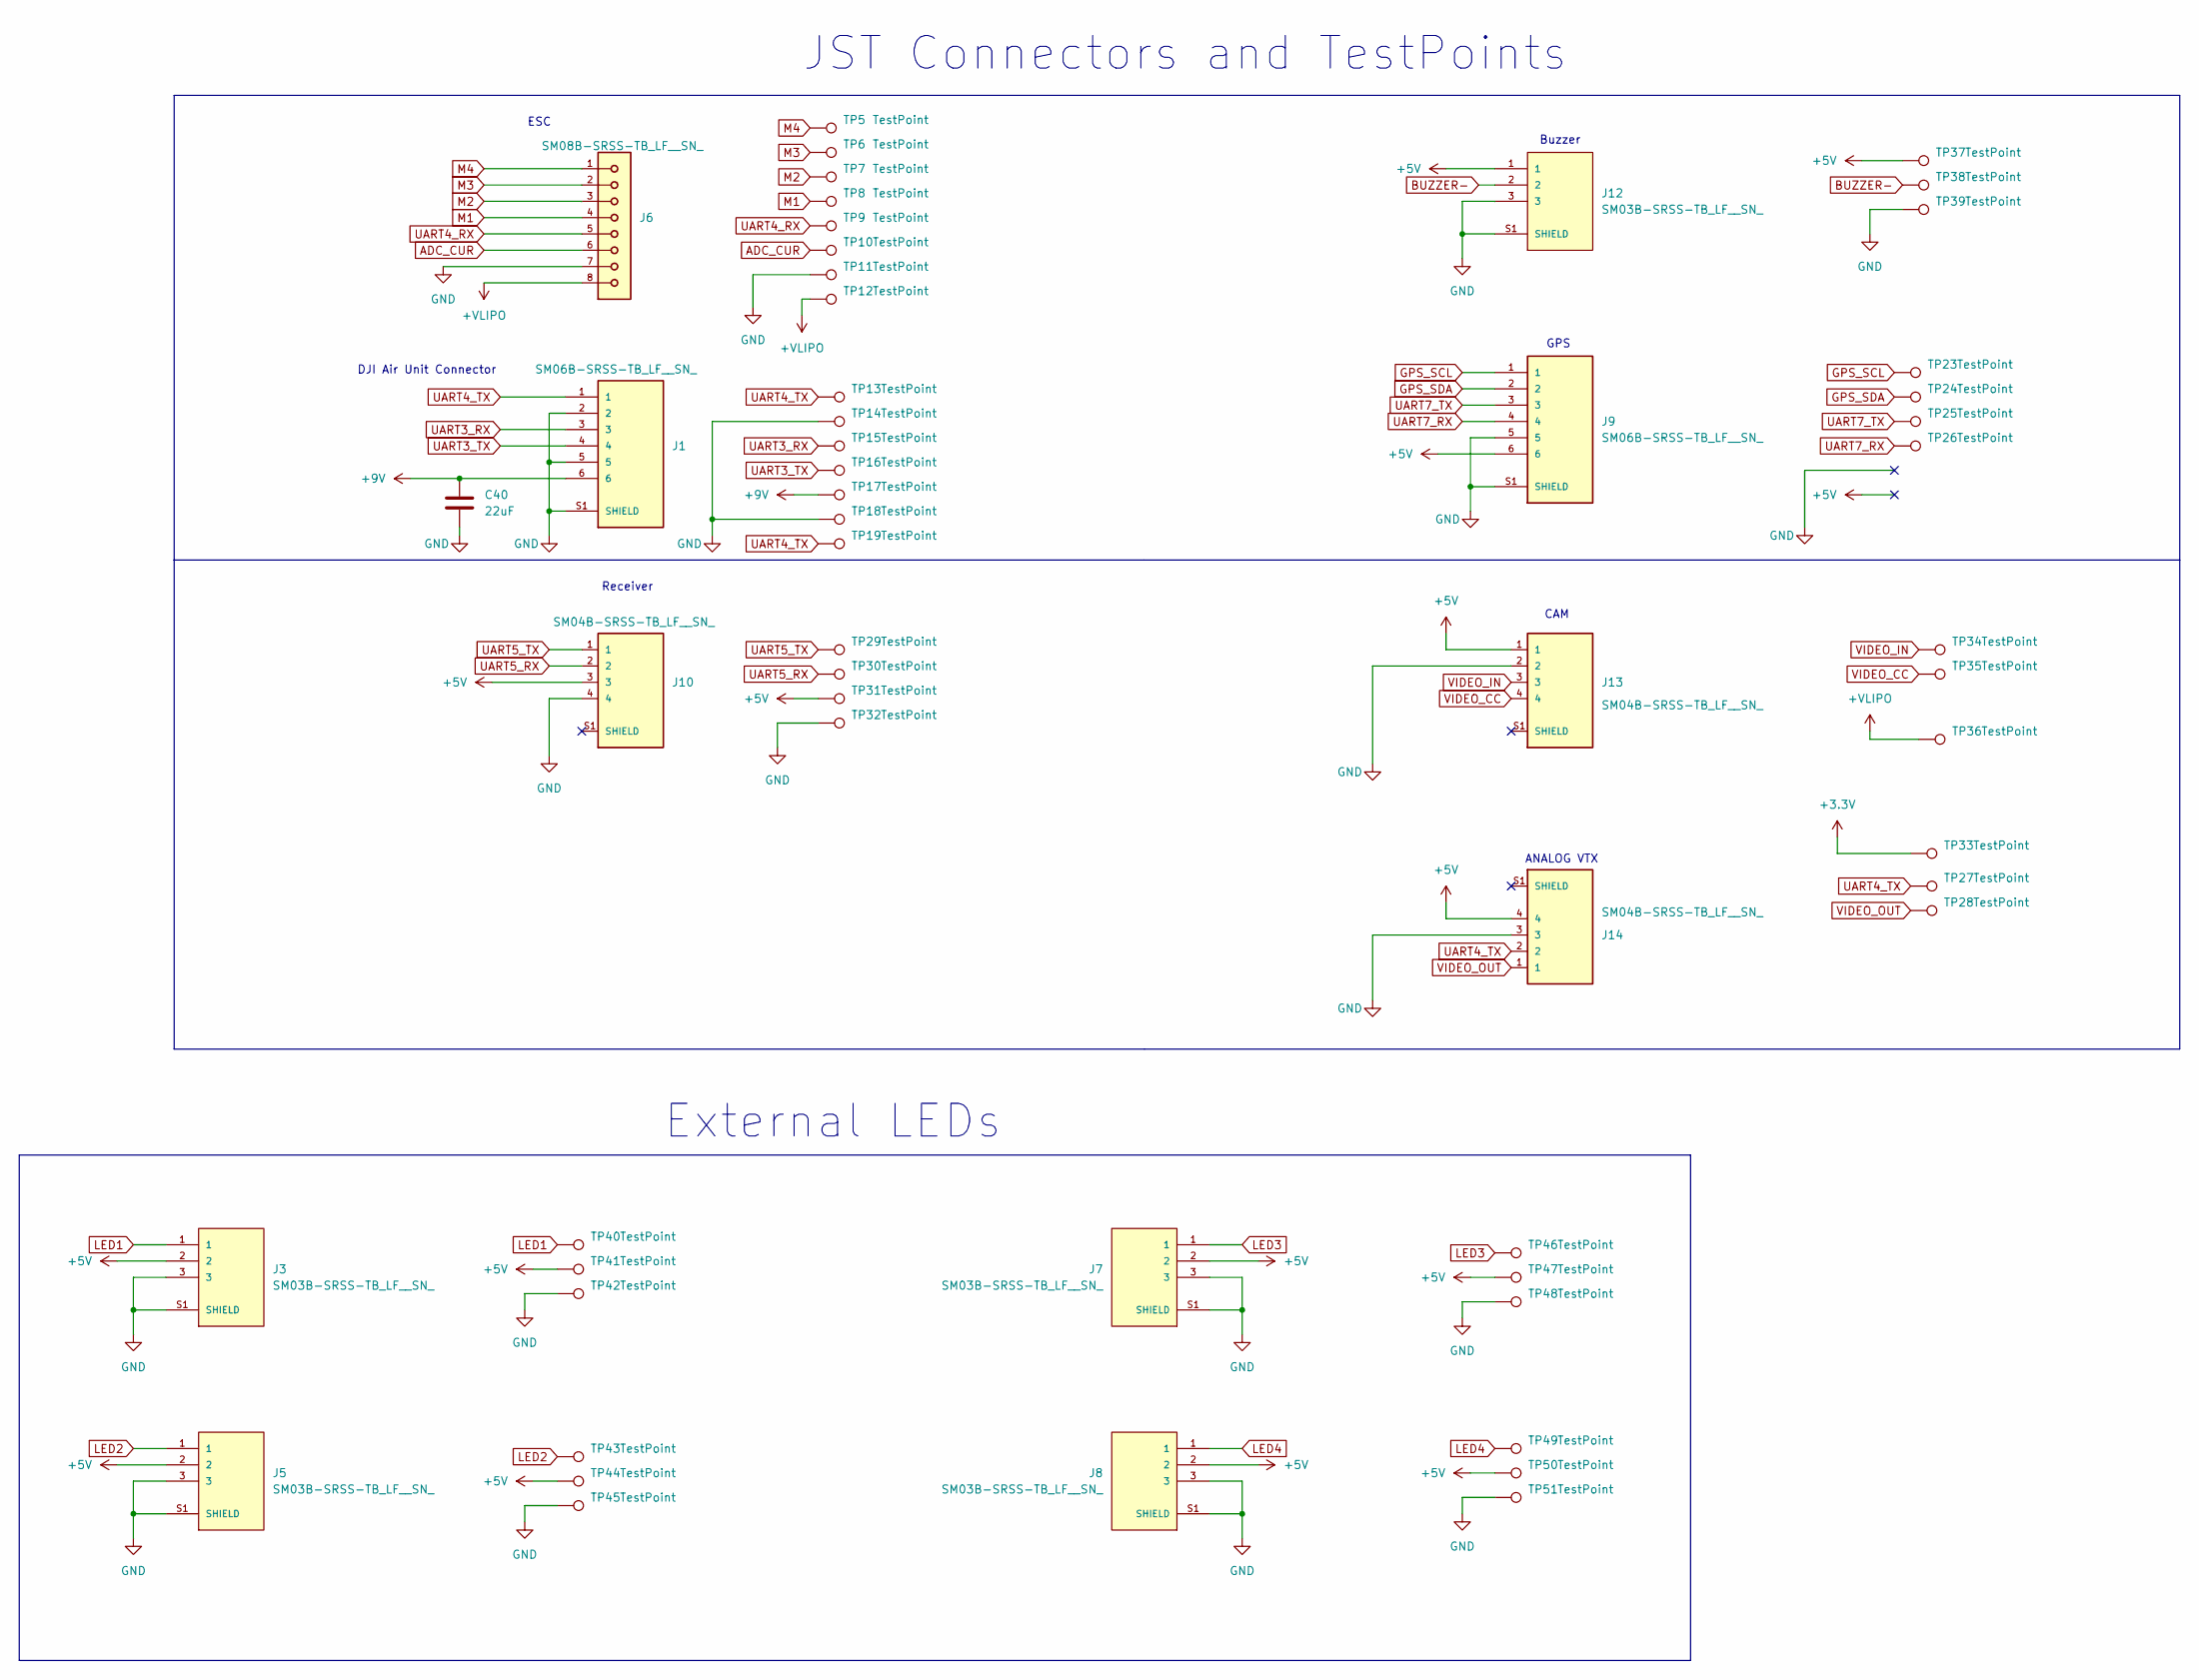
[picture p36: schematic interface.kicad_sch, MagnumFC]

Parts:
C40: 22uF; C_0805_2012Metric; MANUFACTURER PART NUMBER HGC0805R5226M350NSLJ; LCSC C22367832
J1, J9: SM06B-SRSS-TB_LF__SN_; JST_SM06B-SRSS-TB_LF__SN_; MANUFACTURER PART NUMBER HC-1.0-6PWT; LCSC C2845365
J3, J5, J7, J8, J12: SM03B-SRSS-TB_LF__SN_; JST_SM03B-SRSS-TB_LF__SN_; MANUFACTURER PART NUMBER HC-1.0-3PWT; LCSC C2845362
J6: SM08B-SRSS-TB_LF__SN_; JST_SM08B-SRSS-TB_LF__SN_; MANUFACTURER PART NUMBER SM08B-SRSS-TB(LF)(SN); LCSC C160407
J10, J13, J14: SM04B-SRSS-TB_LF__SN_; JST_SM04B-SRSS-TB_LF__SN_; MANUFACTURER PART NUMBER HC-1.0-4PWT; LCSC C2845363
TP5, TP6, TP7, TP8, TP9, TP10, TP40, TP41, TP42, TP43, TP44, TP45, TP46, TP47, TP48, TP49, TP50, TP51: TestPoint; TestPoint_Pad_D1.0mm
TP11, TP12: TestPoint; TestPoint_Pad_D2.0mm
TP13, TP14, TP15, TP16, TP18, TP19, TP23, TP24, TP25, TP26, TP27, TP28, TP29, TP30, TP32, TP33, TP34, TP35, TP36, TP38, TP39: TestPoint; TestPoint_Pad_1.0x1.0mm
TP17, TP31, TP37: TestPoint; TestPoint_Pad_2.0x2.0mm

Connections:
+3.3V: TP33.1 (1_1); also elsewhere on the board
+5V: J3.2, J5.2, J7.2, J8.2, J9.6, J10.3, J12.1, J13.1, J14.4, TP31.1 (1_1), TP37.1 (1_1), TP41.1 (1_1), TP44.1 (1_1), TP47.1 (1_1), TP50.1 (1_1); also elsewhere on the board
+9V: C40.1, J1.6, TP17.1 (1_1); also elsewhere on the board
+VLIPO: J6.8, TP12.1 (1_1), TP36.1 (1_1); also elsewhere on the board
ADC_CUR: J6.6, TP10.1 (1_1); also elsewhere on the board
BUZZER-: J12.2, TP38.1 (1_1); also elsewhere on the board
GND: C40.2, J1.2, J1.5, J1.S1 (SHIELD), J1.S2 (SHIELD), J3.3, J3.S1 (SHIELD), J3.S2 (SHIELD), J5.3, J5.S1 (SHIELD), J5.S2 (SHIELD), J6.7, J7.3, J7.S1 (SHIELD), J7.S2 (SHIELD), J8.3, J8.S1 (SHIELD), J8.S2 (SHIELD), J9.5, J9.S1 (SHIELD), J9.S2 (SHIELD), J10.4, J12.3, J12.S1 (SHIELD), J12.S2 (SHIELD), J13.2, J14.3, TP11.1 (1_1), TP14.1 (1_1), TP18.1 (1_1), TP32.1 (1_1), TP39.1 (1_1), TP42.1 (1_1), TP45.1 (1_1), TP48.1 (1_1), TP51.1 (1_1); also elsewhere on the board
GPS_SCL: J9.1, TP23.1 (1_1); also elsewhere on the board
GPS_SDA: J9.2, TP24.1 (1_1); also elsewhere on the board
LED1: J3.1, TP40.1 (1_1); also elsewhere on the board
LED2: J5.1, TP43.1 (1_1); also elsewhere on the board
LED3: J7.1, TP46.1 (1_1); also elsewhere on the board
LED4: J8.1, TP49.1 (1_1); also elsewhere on the board
M1: J6.4, TP8.1 (1_1); also elsewhere on the board
M2: J6.3, TP7.1 (1_1); also elsewhere on the board
M3: J6.2, TP6.1 (1_1); also elsewhere on the board
M4: J6.1, TP5.1 (1_1); also elsewhere on the board
UART3_RX: J1.3, TP15.1 (1_1); also elsewhere on the board
UART3_TX: J1.4, TP16.1 (1_1); also elsewhere on the board
UART4_RX: J6.5, TP9.1 (1_1); also elsewhere on the board
UART4_TX: J1.1, J14.2, TP13.1 (1_1), TP19.1 (1_1), TP27.1 (1_1); also elsewhere on the board
UART5_RX: J10.2, TP30.1 (1_1); also elsewhere on the board
UART5_TX: J10.1, TP29.1 (1_1); also elsewhere on the board
UART7_RX: J9.4, TP26.1 (1_1); also elsewhere on the board
UART7_TX: J9.3, TP25.1 (1_1); also elsewhere on the board
VIDEO_CC: J13.4, TP35.1 (1_1); also elsewhere on the board
VIDEO_IN: J13.3, TP34.1 (1_1); also elsewhere on the board
VIDEO_OUT: J14.1, TP28.1 (1_1); also elsewhere on the board

Notes on the sheet:
ANALOG VTX
External LEDs
Buzzer
DJI Air Unit Connector
GPS
JST Connectors and TestPoints
ESC
Receiver
CAM

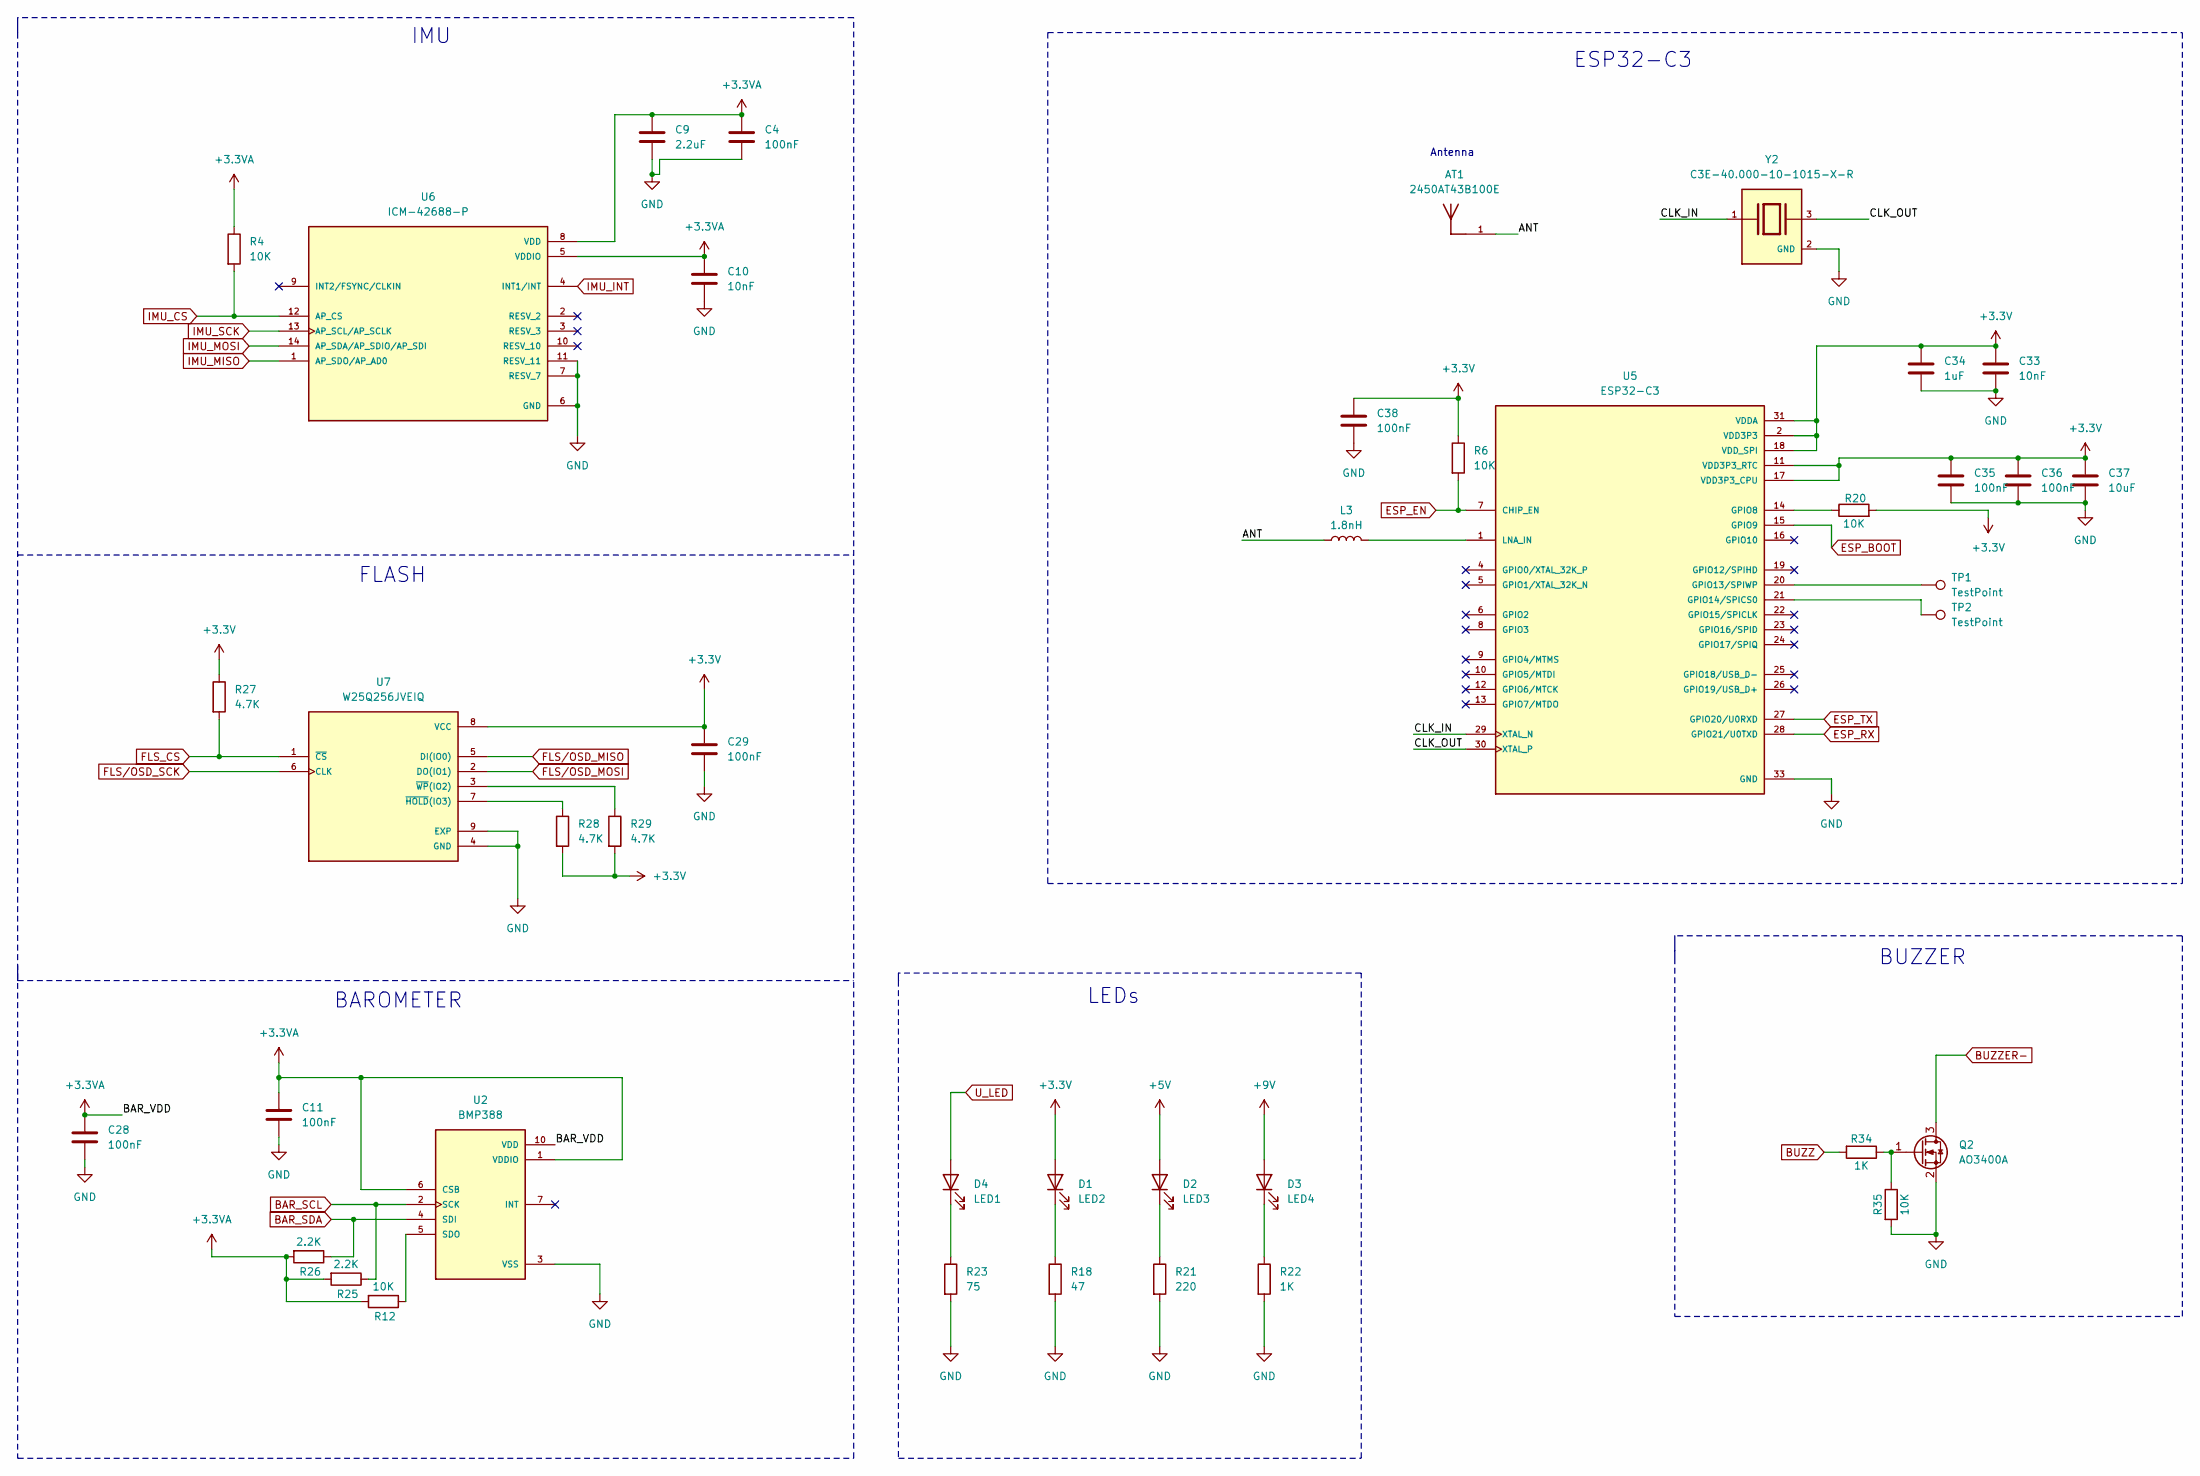
[picture p37: schematic sensor.kicad_sch, MagnumFC]

Parts:
AT1: 2450AT43B100E; ANTENNA_2450AT43B100E; PARTREV N/A; LCSC C2917721
C4, C11, C28, C29, C35, C36, C38: 100nF; C_0402_1005Metric; MANUFACTURER PART NUMBER CL05A104KA5NNNC; LCSC C100072
C9: 2.2uF; C_0402_1005Metric; MANUFACTURER PART NUMBER CL05A225KP5NSNC; LCSC C107369
C10, C33: 10nF; C_0402_1005Metric; MANUFACTURER PART NUMBER CL05B103KB5NNNC; LCSC C15195
C34: 1uF; C_0402_1005Metric; MANUFACTURER PART NUMBER CL05A105KO5NNNC; LCSC C29266
C37: 10uF; C_0805_2012Metric; MANUFACTURER PART NUMBER CL21A106KBYQNNE; LCSC C2932476
D1: LED2; LED_0805_2012Metric; MANUFACTURER PART NUMBER KT-0805B; LCSC C2293
D2: LED3; LED_0805_2012Metric; MANUFACTURER PART NUMBER KT-0805Y; LCSC C2296
D3: LED4; LED_0805_2012Metric; MANUFACTURER PART NUMBER KT-0805G; LCSC C2297
D4: LED1; LED_0805_2012Metric; MANUFACTURER PART NUMBER KT-0805R; LCSC C2295
L3: 1.8nH; L_0402_1005Metric; MANUFACTURER PART NUMBER LQG15HS1N8S02D; LCSC C77107
Q2: AO3400A; SOT-23; MANUFACTURER PART NUMBER AO3400A; LCSC C20917
R4, R6, R12, R20, R35: 10K; R_0402_1005Metric; MANUFACTURER PART NUMBER RC0402JR-0710KL; LCSC C60489
R18: 47; R_0402_1005Metric; MANUFACTURER PART NUMBER RC0402FR-0747RL; LCSC C137973
R21: 220; R_0402_1005Metric; MANUFACTURER PART NUMBER RC0402FR-07220RL; LCSC C112291
R22, R34: 1K; R_0402_1005Metric; MANUFACTURER PART NUMBER RC0402FR-071KL; LCSC C106235
R23: 75; R_0402_1005Metric; MANUFACTURER PART NUMBER RC0402JR-0775RL; LCSC C137841
R25, R26: 2.2K; R_0402_1005Metric; MANUFACTURER PART NUMBER RC0402JR-072K2L; LCSC C163447
R27, R28, R29: 4.7K; R_0402_1005Metric; MANUFACTURER PART NUMBER RC0402FR-074K7L; LCSC C105871
TP1, TP2: TestPoint; TestPoint_Pad_D1.0mm
U2: BMP388; XDCR_BMP388; PARTREV 1.7; LCSC C779278
U5: ESP32-C3; QFN50P500X500X90-33N; PARTREV 2.0; LCSC C2838500
U6: ICM-42688-P; PQFN50P300X250X97-14N; PARTREV 1.2; LCSC C1850418, Mouser No: 410-ICM-42688-P
U7: W25Q256JVEIQ; IC_W25N04KVZEIR; PARTREV I; LCSC C97522
Y2: C3E-40.000-10-1015-X-R; XTAL_C3E-40.000-10-1015-X-R; PARTREV August 01, 2022; LCSC C5444549

Connections:
+3.3V: C29.1, C33.1, C34.1, C35.1, C36.1, C37.1, C38.1, D1.2 (A), R6.1, R20.2, R27.1, R28.2, R29.2, U5.2 (VDD3P3), U5.3 (VDD3P3), U5.11 (VDD3P3_RTC), U5.17 (VDD3P3_CPU), U5.18 (VDD_SPI), U5.31 (VDDA), U5.32 (VDDA), U7.8 (VCC); also elsewhere on the board
+3.3VA: C4.1, C9.1, C10.1, C11.1, C28.1, R4.1, R12.2, R25.2, R26.2, U2.1 (VDDIO), U2.6 (CSB), U2.10 (VDD), U6.5 (VDDIO), U6.8 (VDD); also elsewhere on the board
+5V: D2.2 (A); also elsewhere on the board
+9V: D3.2 (A); also elsewhere on the board
/Sensor Section/ANT: AT1.1, L3.1
/Sensor Section/CLK_IN: U5.29 (XTAL_N), Y2.1
/Sensor Section/CLK_OUT: U5.30 (XTAL_P), Y2.3
BAR_SCL: R25.1, U2.2 (SCK); also elsewhere on the board
BAR_SDA: R26.1, U2.4 (SDI); also elsewhere on the board
BUZZ: R34.2; also elsewhere on the board
BUZZER-: Q2.3 (D); also elsewhere on the board
ESP_BOOT: U5.15 (GPIO9); also elsewhere on the board
ESP_EN: R6.2, U5.7 (CHIP_EN); also elsewhere on the board
ESP_RX: U5.28 (GPIO21/U0TXD); also elsewhere on the board
ESP_TX: U5.27 (GPIO20/U0RXD); also elsewhere on the board
FLS_CS: R27.2, U7.1 (~CS); also elsewhere on the board
FLS/OSD_MISO: U7.5 (DI(IO0)); also elsewhere on the board
FLS/OSD_MOSI: U7.2 (DO(IO1)); also elsewhere on the board
FLS/OSD_SCK: U7.6 (CLK); also elsewhere on the board
GND: C4.2, C9.2, C10.2, C11.2, C28.2, C29.2, C33.2, C34.2, C35.2, C36.2, C37.2, C38.2, Q2.2 (S), R18.2, R21.2, R22.2, R23.2, R35.2, U2.3 (VSS), U2.8 (VSS), U2.9 (VSS), U5.33 (GND), U6.6 (GND), U6.7 (RESV_7), U6.11 (RESV_11), U7.4 (GND), U7.9 (EXP), Y2.2 (GND), Y2.4 (GND); also elsewhere on the board
IMU_CS: R4.2, U6.12 (AP_CS); also elsewhere on the board
IMU_INT: U6.4 (INT1/INT); also elsewhere on the board
IMU_MISO: U6.1 (AP_SDO/AP_AD0); also elsewhere on the board
IMU_MOSI: U6.14 (AP_SDA/AP_SDIO/AP_SDI); also elsewhere on the board
IMU_SCK: U6.13 (AP_SCL/AP_SCLK); also elsewhere on the board
unnamed: D1.1 (K), R18.1
unnamed: D2.1 (K), R21.1
unnamed: D3.1 (K), R22.1
unnamed: D4.1 (K), R23.1
unnamed: Q2.1 (G), R34.1, R35.1
unnamed: R12.1, U2.5 (SDO)
unnamed: R20.1, U5.14 (GPIO8)
unnamed: TP1.1 (1_1), U5.20 (GPIO13/SPIWP)
unnamed: TP2.1 (1_1), U5.21 (GPIO14/SPICS0)
unnamed: L3.2, U5.1 (LNA_IN)
unnamed: R28.1, U7.7 (~HOLD(IO3))
unnamed: R29.1, U7.3 (~WP(IO2))
U_LED: D4.2 (A); also elsewhere on the board

Notes on the sheet:
FLASH
BUZZER
BAROMETER
LEDs
IMU
ESP32-C3
Antenna
