poojithas956/MagnumFC/PCB/MagnumFC.kicad_pcb

## KiCad design PCB/MagnumFC.kicad_pcb (continued)

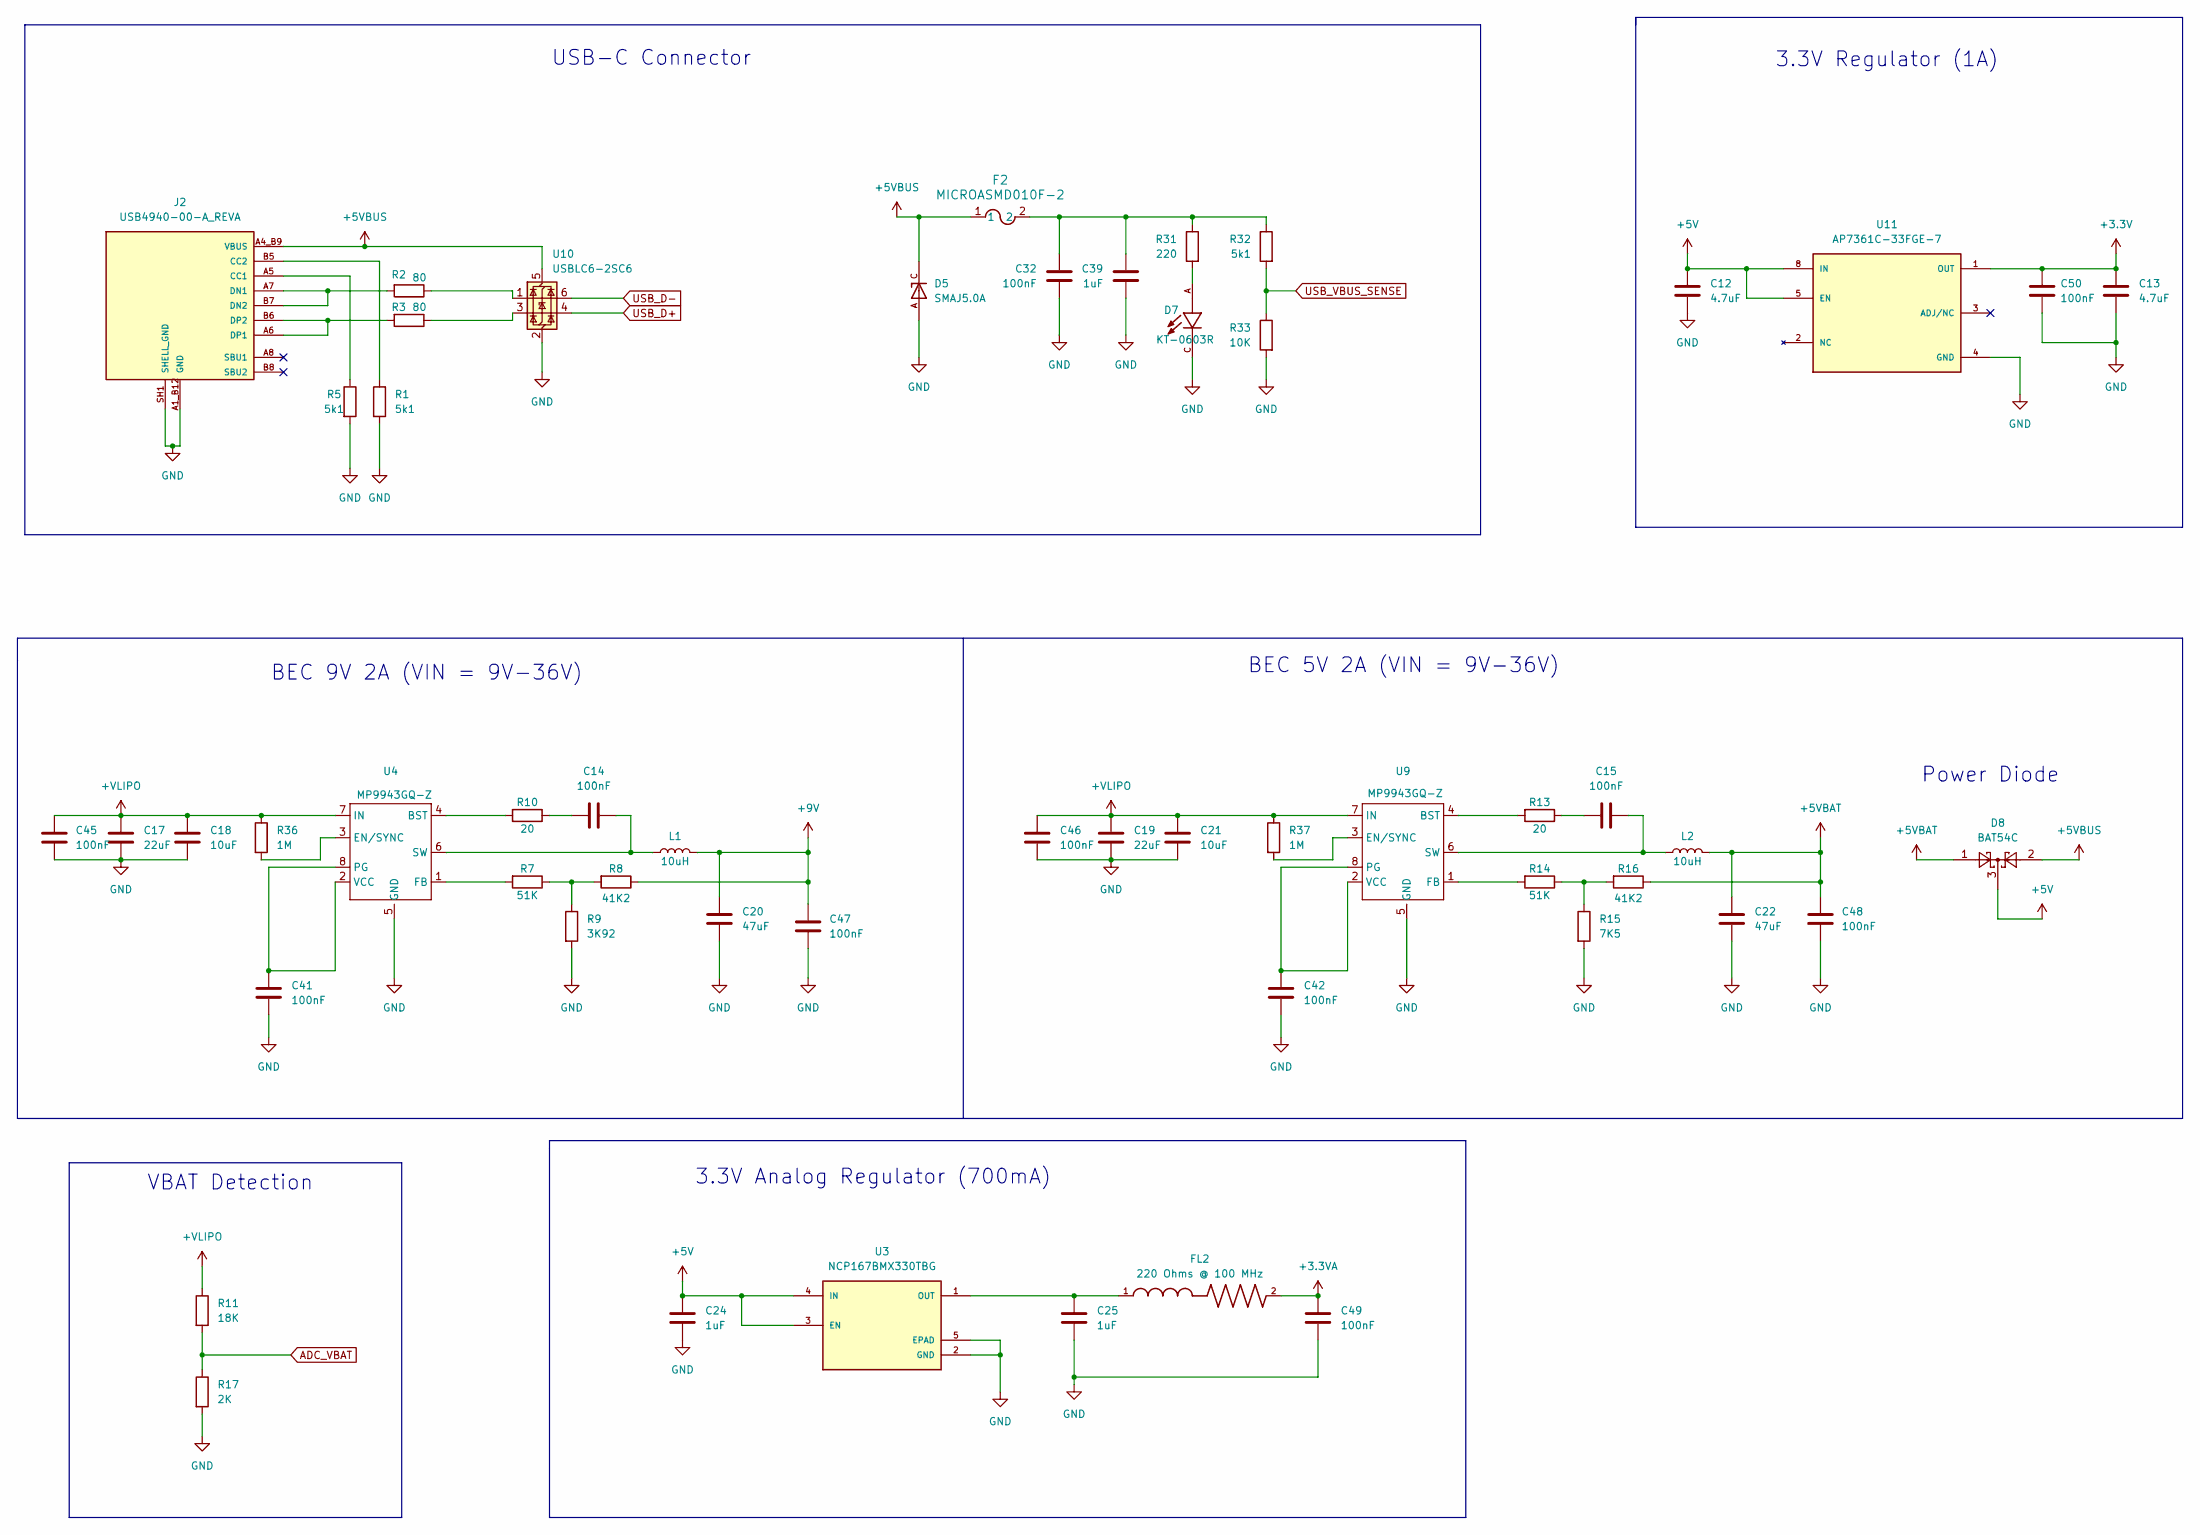
[picture p38: schematic pwr.kicad_sch, MagnumFC]

Parts:
C12, C13: 4.7uF; C_0603_1608Metric; MANUFACTURER PART NUMBER CL10A475KO8NNNC; LCSC C19666
C14, C15, C32, C41, C42, C45, C46, C47, C48, C49, C50: 100nF; C_0402_1005Metric; MANUFACTURER PART NUMBER CL05A104KA5NNNC; LCSC C100072
C17, C19: 22uF; C_0805_2012Metric; MANUFACTURER PART NUMBER HGC0805R5226M350NSLJ; LCSC C22367832
C18, C21: 10uF; C_0805_2012Metric; MANUFACTURER PART NUMBER CL21A106KBYQNNE; LCSC C2932476
C20, C22: 47uF; C_0805_2012Metric; MANUFACTURER PART NUMBER CL21A476MPYNNWE; LCSC C5596752
C24, C25, C39: 1uF; C_0402_1005Metric; MANUFACTURER PART NUMBER CL05A105KO5NNNC; LCSC C29266
D5: SMAJ5.0A; DIOM4325X250N; PARTREV S2102; LCSC C83329
D7: KT-0603R; LED_KT-0603R; PARTREV 2013/01/24; LCSC C2286
D8: BAT54C; SOT-23; MANUFACTURER PART NUMBER BAT54CLT1G; LCSC C14308
F2: MICROASMD010F-2; FUSE_MICROASMD010F_LTF; MANUFACTURER PART NUMBER MICROSMD010F-2; LCSC C2649903
FL2: 220 Ohms @ 100 MHz; L_0402_1005Metric; MANUFACTURER PART NUMBER BLM15BB221SN1D; LCSC C85818
J2: USB4940-00-A_REVA; GCT_USB4940-00-A_REVA; PARTREV A; LCSC C54829818
L1, L2: 10uH; L_Changjiang_FTC404020S; MANUFACTURER PART NUMBER GXTC0420-100-MT; LCSC C53198553
R1, R5, R32: 5k1; R_0402_1005Metric; MANUFACTURER PART NUMBER RC0402FR-075K1L; LCSC C105872
R2, R3: 80; R_0402_1005Metric; MANUFACTURER PART NUMBER RC0402FR-0780R6L; LCSC C185392
R7, R14: 51K; R_0402_1005Metric; MANUFACTURER PART NUMBER RC0402FR-0751KL; LCSC C107229
R8, R16: 41K2; R_0402_1005Metric; MANUFACTURER PART NUMBER CRCW040241K2FKED; LCSC C844310
R9: 3K92; R_0402_1005Metric; MANUFACTURER PART NUMBER RC0402FR-073K9L; LCSC C131467
R10, R13: 20; R_0402_1005Metric; MANUFACTURER PART NUMBER RC0402FR-0720RL; LCSC C138031
R11: 18K; R_0402_1005Metric; MANUFACTURER PART NUMBER 0402WGF1802TCE; LCSC C25762
R15: 7K5; R_0402_1005Metric; MANUFACTURER PART NUMBER 0402WGF7501TCE; LCSC C25918
R17: 2K; R_0402_1005Metric; MANUFACTURER PART NUMBER RC0402FR-072KL; LCSC C60488
R31: 220; R_0402_1005Metric; MANUFACTURER PART NUMBER RC0402FR-07220RL; LCSC C112291
R33: 10K; R_0402_1005Metric; MANUFACTURER PART NUMBER RC0402JR-0710KL; LCSC C60489
R36, R37: 1M; R_0402_1005Metric; MANUFACTURER PART NUMBER RC0402JR-071ML; LCSC C93949
U3: NCP167BMX330TBG; VREG_NCP167BMX330TBG; PARTREV 5; LCSC C892227
U4, U9: MP9943GQ-Z; QFN-8_MP9943_MNP; MANUFACTURER PART NUMBER MP9943GQ-Z; LCSC Mouser No: 946-MP9943GQ-Z
U10: USBLC6-2SC6; SOT-23-6; MANUFACTURER PART NUMBER USBLC6-2SC6; LCSC C7519
U11: AP7361C-33FGE-7; SON65P300X300X63-9N; PARTREV 5 - 2; LCSC C151007

Connections:
+3.3V: C13.1, C50.1, U11.1 (OUT); also elsewhere on the board
+3.3VA: C49.1, FL2.2; also elsewhere on the board
+5V: C12.1, C24.1, D8.3, U3.3 (EN), U3.4 (IN), U11.5 (EN), U11.8 (IN); also elsewhere on the board
+5VBAT: C22.1, C48.1, D8.1, L2.2, R16.1
+5VBUS: D5.C, D8.2, F2.1, J2.A4_B9 (VBUS), J2.B4_A9 (VBUS), U10.5 (VBUS)
+9V: C20.1, C47.1, L1.2, R8.1; also elsewhere on the board
+VLIPO: C17.1, C18.1, C19.1, C21.1, C45.1, C46.1, R11.1, R36.1, R37.1, U4.7 (IN), U9.7 (IN); also elsewhere on the board
ADC_VBAT: R11.2, R17.1; also elsewhere on the board
GND: C12.2, C13.2, C17.2, C18.2, C19.2, C20.2, C21.2, C22.2, C24.2, C25.2, C32.2, C39.2, C41.2, C42.2, C45.2, C46.2, C47.2, C48.2, C49.2, C50.2, D5.A, D7.C, J2.A1_B12 (GND), J2.B1_A12 (GND), J2.SH1 (SHELL_GND), J2.SH2 (SHELL_GND), J2.SH3 (SHELL_GND), J2.SH4 (SHELL_GND), R1.2, R5.2, R9.2, R15.2, R17.2, R33.2, U3.2 (GND), U3.5 (EPAD), U4.5 (GND), U9.5 (GND), U10.2 (GND), U11.4 (GND), U11.9 (GND); also elsewhere on the board
unnamed: C14.2, R10.1
unnamed: C15.2, R13.1
unnamed: C32.1, C39.1, F2.2, R31.1, R32.1
unnamed: D7.A, R31.2
unnamed: J2.A5 (CC1), R5.1
unnamed: J2.B5 (CC2), R1.1
unnamed: J2.A7 (DN1), J2.B7 (DN2), R2.2
unnamed: J2.A6 (DP1), J2.B6 (DP2), R3.2
unnamed: R2.1, U10.1 (I/O1)
unnamed: R3.1, U10.3 (I/O2)
unnamed: R7.1, R8.2, R9.1
unnamed: R14.1, R15.1, R16.2
unnamed: C25.1, FL2.1, U3.1 (OUT)
unnamed: R10.2, U4.4 (BST)
unnamed: R36.2, U4.3 (EN/SYNC)
unnamed: R7.2, U4.1 (FB)
unnamed: C41.1, U4.2 (VCC), U4.8 (PG)
unnamed: C14.1, L1.1, U4.6 (SW)
unnamed: R13.2, U9.4 (BST)
unnamed: R37.2, U9.3 (EN/SYNC)
unnamed: R14.2, U9.1 (FB)
unnamed: C42.1, U9.2 (VCC), U9.8 (PG)
unnamed: C15.1, L2.1, U9.6 (SW)
USB_D+: U10.4 (I/O2); also elsewhere on the board
USB_D-: U10.6 (I/O1); also elsewhere on the board
USB_VBUS_SENSE: R32.2, R33.1; also elsewhere on the board

Notes on the sheet:
USB-C Connector
3.3V Analog Regulator (700mA)
VBAT Detection
BEC 5V 2A (VIN = 9V-36V)
BEC 9V 2A (VIN = 9V-36V)
Power Diode
3.3V Regulator (1A)

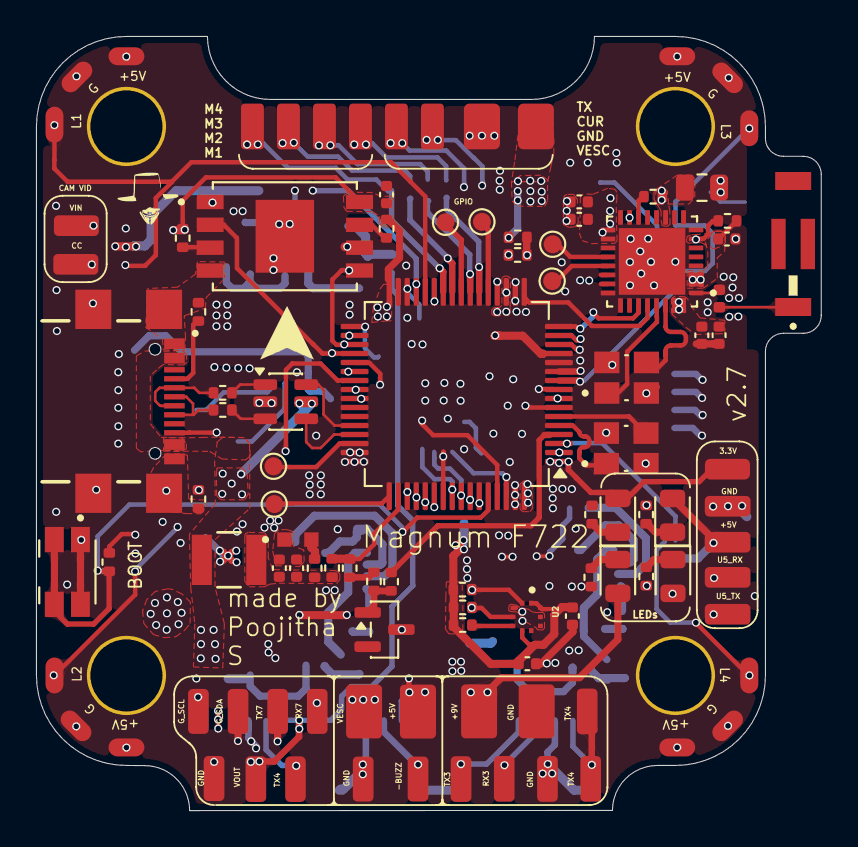
[picture p39: board MagnumFC.kicad_pcb from above]

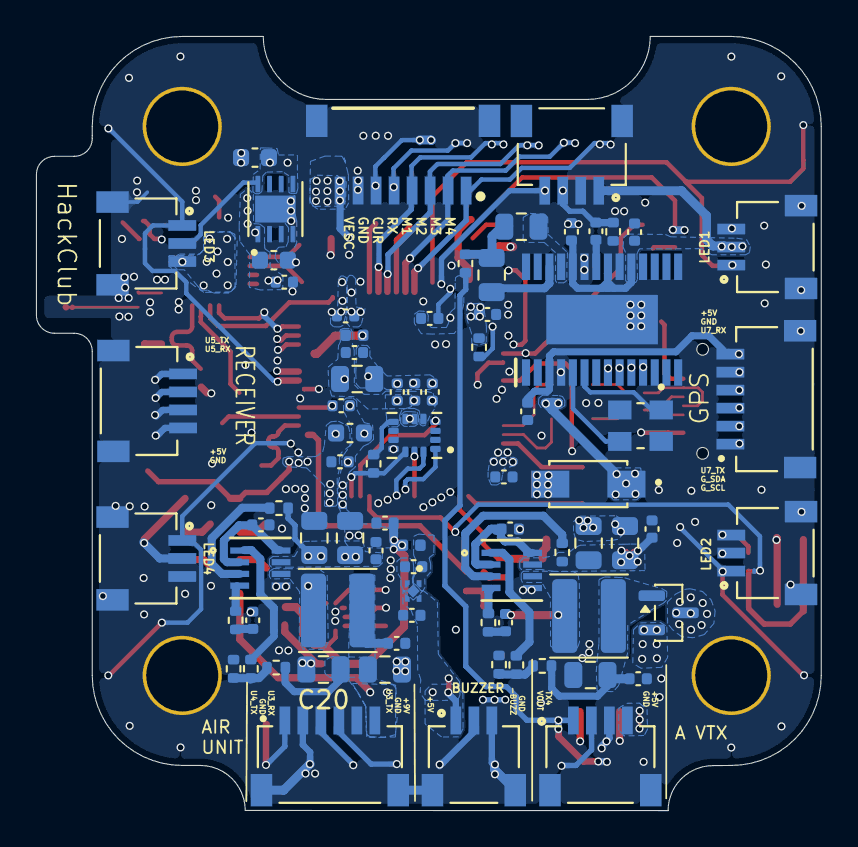
[picture p40: board MagnumFC.kicad_pcb from below]

Board: 6 copper layers, 43.6 x 43.0 mm, 180 parts (77 on the bottom side), 107 nets.

Other parts of the board:
TP36#2: TestPoint; TestPoint_Pad_1.0x1.0mm

Their connections:
GND: TP36#2.1 (1_1); also elsewhere on the board
